open-tools/VentaConnected/Images/PCB/Venta_L45_PCB_00_Parts.jpg

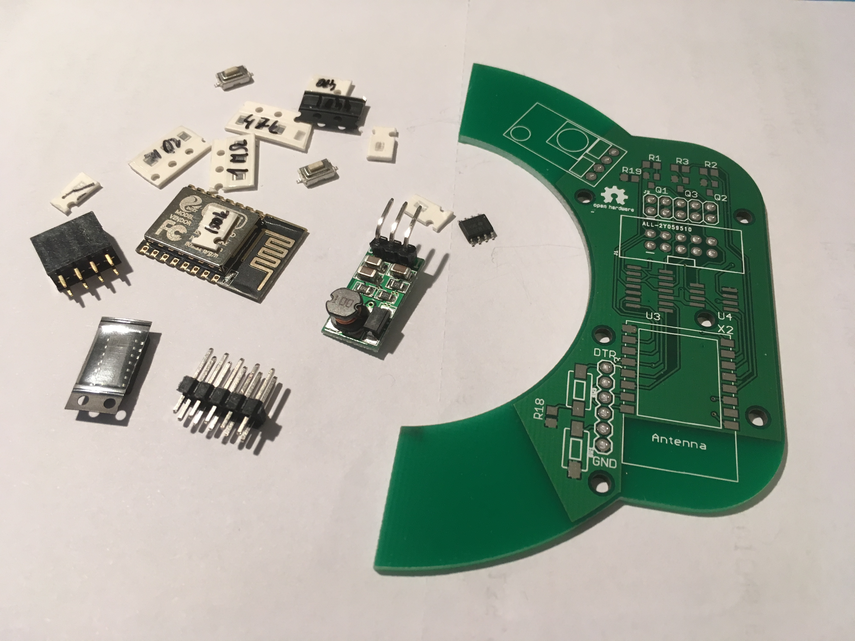
Images/PCB/Venta_L45_PCB_00_Parts.jpg
