open-tools/VentaConnected/Images/Schematics/ESPEasy_Venta_PCB_Schematics.png

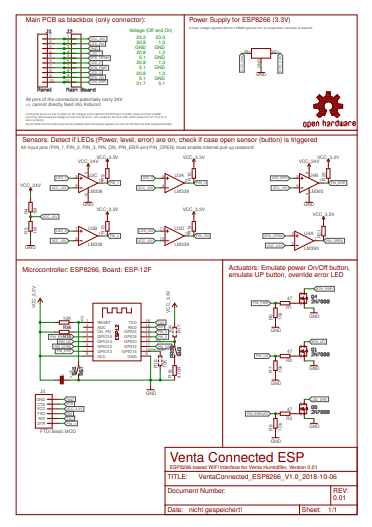
Images/Schematics/ESPEasy_Venta_PCB_Schematics.png
