open-tools/VentaConnected/Maximum_PCB_Outline.pdf

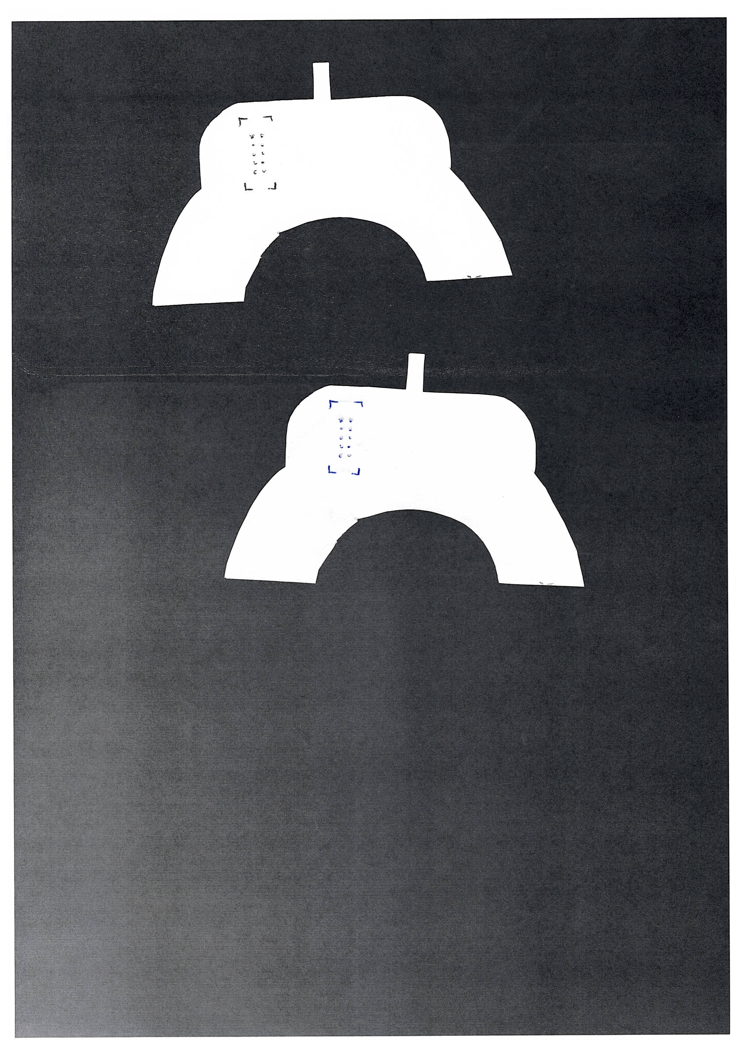
[picture p3: page 1]
