open-tools/VentaConnected/Images/Arduino/20180909_175629.jpg

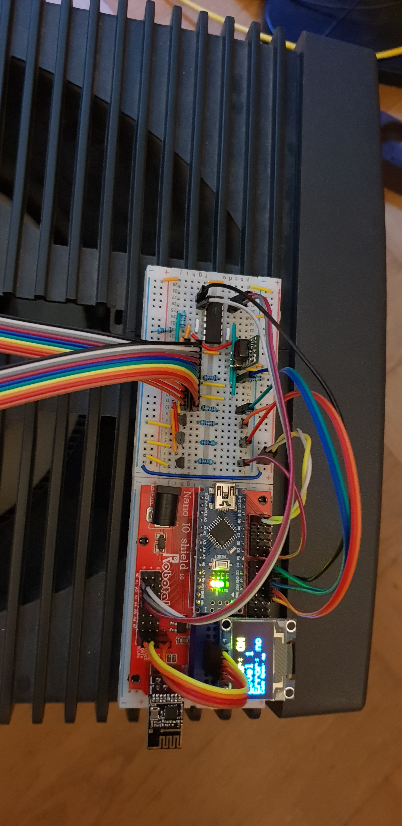
Images/Arduino/20180909_175629.jpg
