open-tools/VentaConnected/Images/Arduino/20180909_180037.jpg

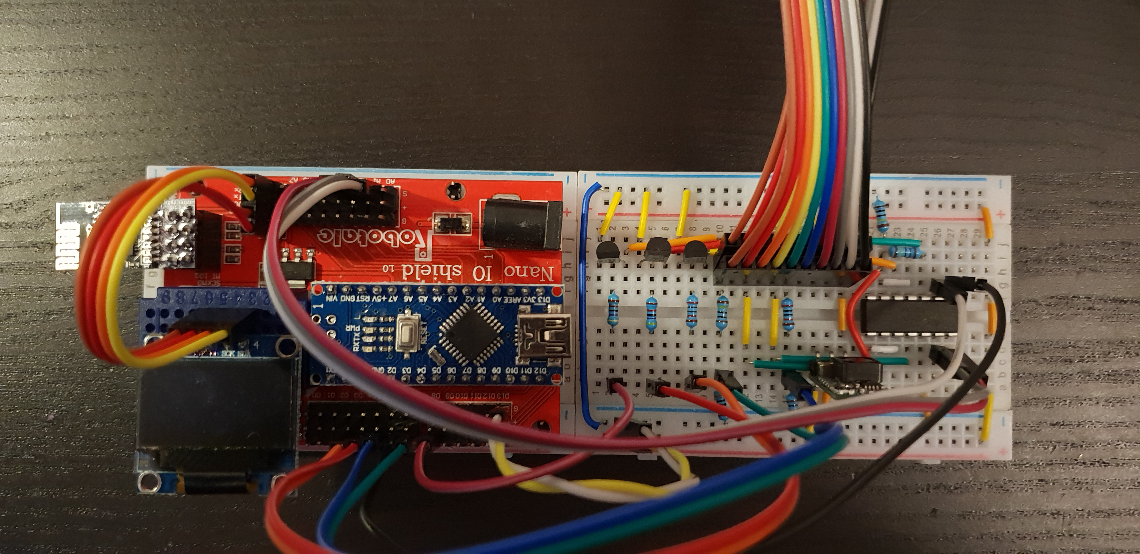
Images/Arduino/20180909_180037.jpg
