open-tools/VentaConnected/Images/Arduino/IMAG2086.jpg

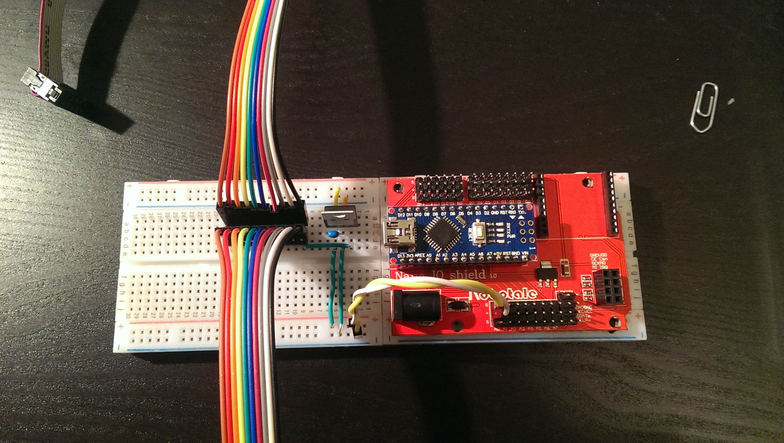
Images/Arduino/IMAG2086.jpg
