open-tools/VentaConnected/Images/Arduino/IMAG2089.jpg

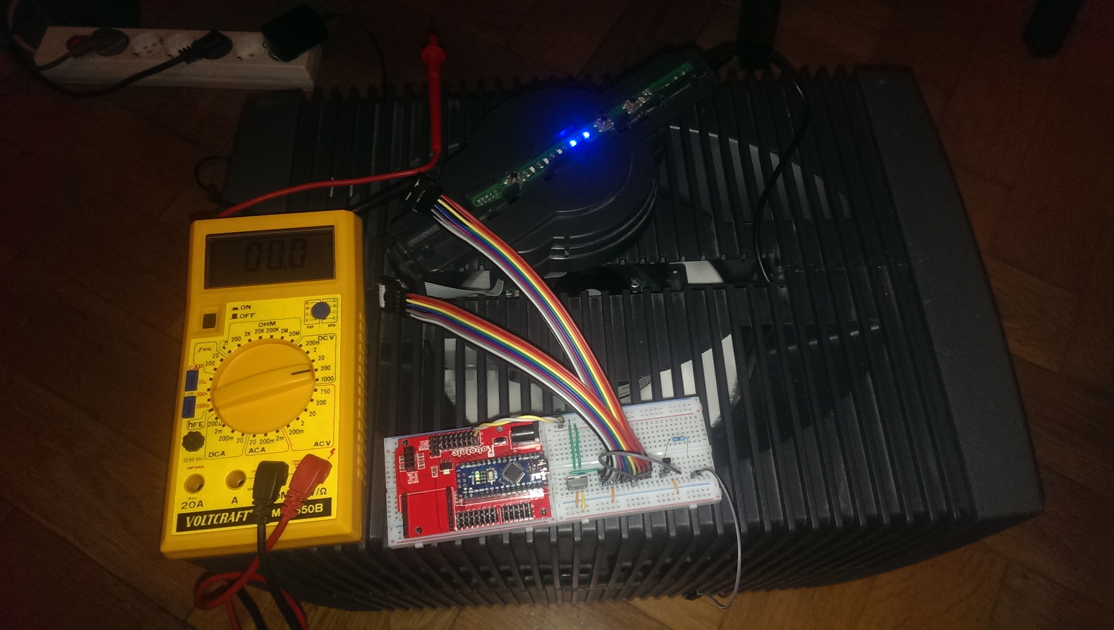
Images/Arduino/IMAG2089.jpg
