open-tools/VentaConnected/Images/Arduino/IMAG2099.jpg

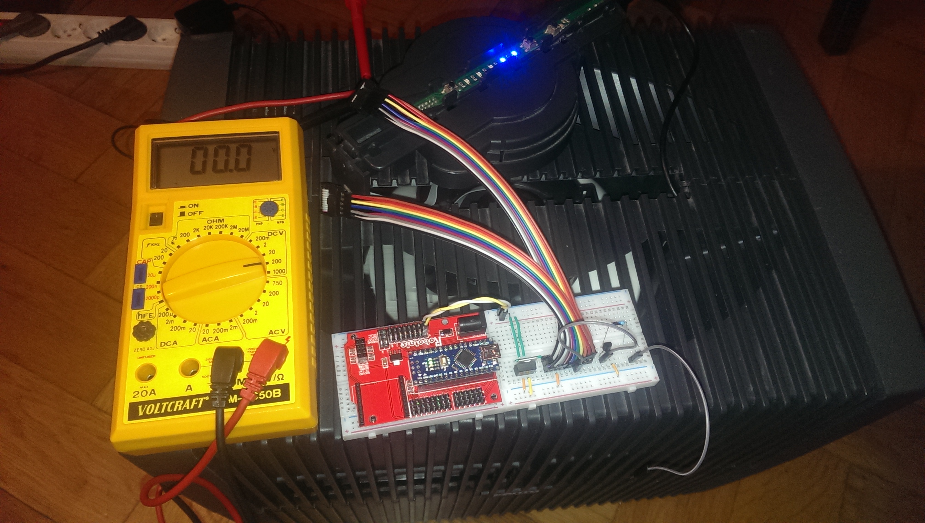
Images/Arduino/IMAG2099.jpg
