open-tools/VentaConnected/Images/Arduino/IMAG2100.jpg

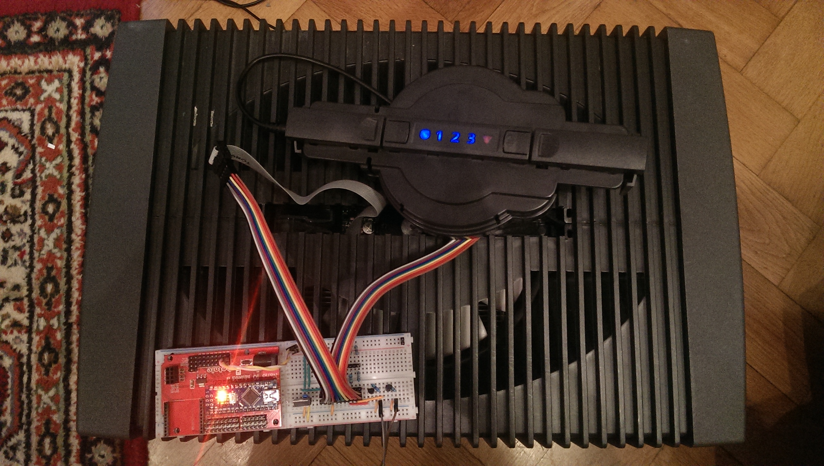
Images/Arduino/IMAG2100.jpg
