open-tools/VentaConnected/Images/Arduino/IMAG2104.jpg

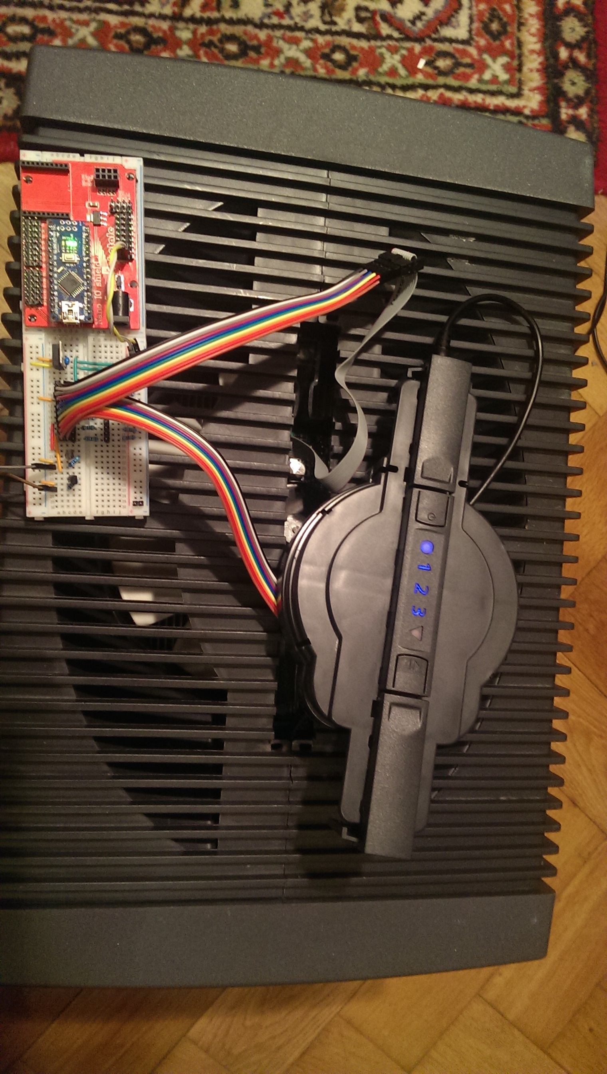
Images/Arduino/IMAG2104.jpg
