open-tools/VentaConnected/Images/Arduino/IMAG2140.jpg

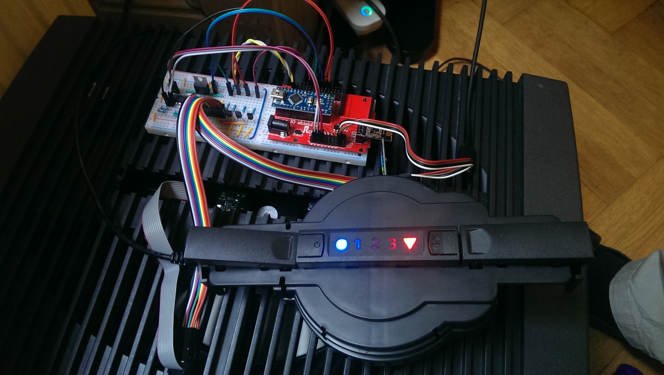
Images/Arduino/IMAG2140.jpg
