open-tools/VentaConnected/Images/Arduino/IMAG2143.jpg

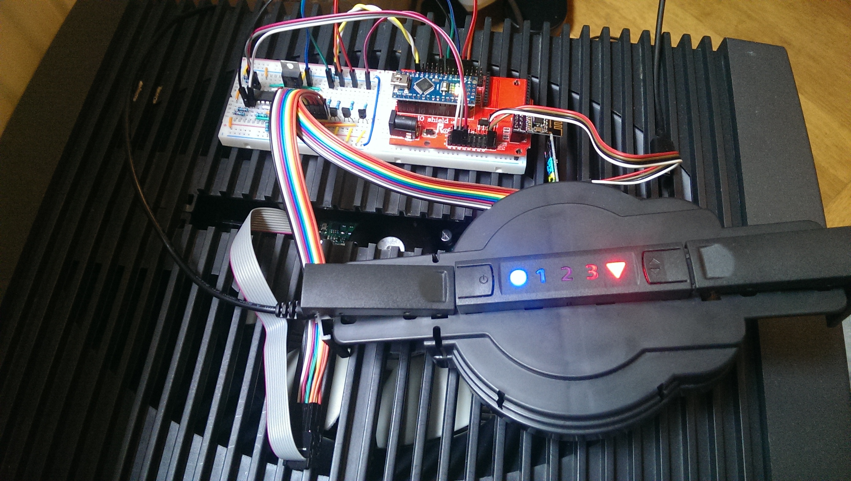
Images/Arduino/IMAG2143.jpg
