open-tools/VentaConnected/Images/Arduino/IMAG2268.jpg

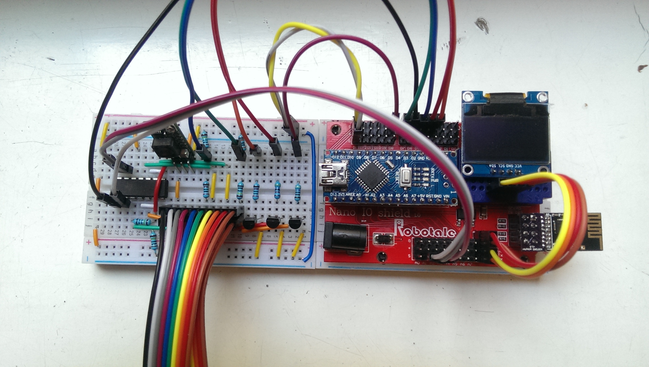
Images/Arduino/IMAG2268.jpg
