open-tools/VentaConnected/Images/Arduino/IMAG2269.jpg

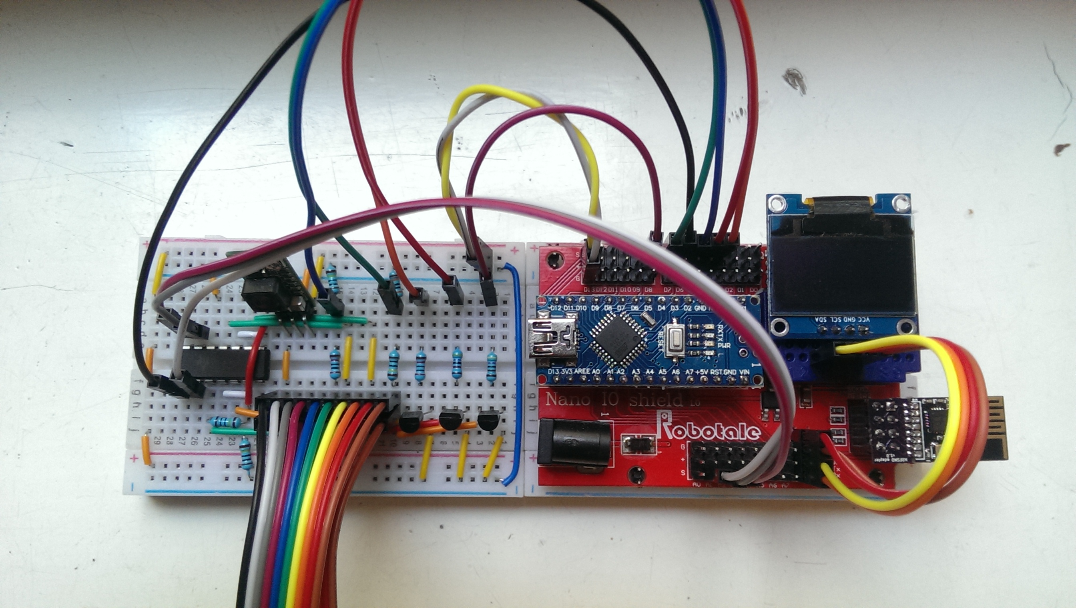
Images/Arduino/IMAG2269.jpg
