open-tools/VentaConnected/Images/Arduino/IMAG2270.jpg

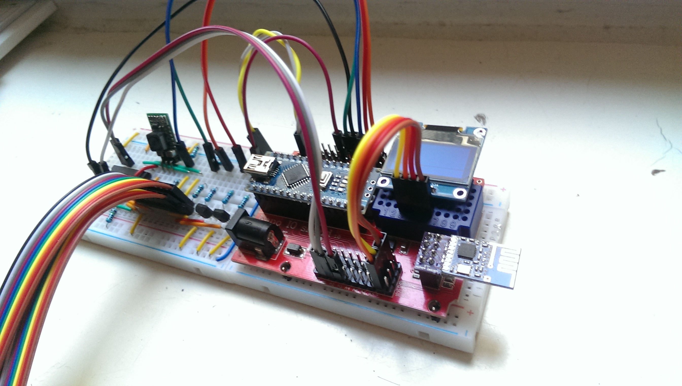
Images/Arduino/IMAG2270.jpg
