open-tools/VentaConnected/Images/Arduino/IMAG2271.jpg

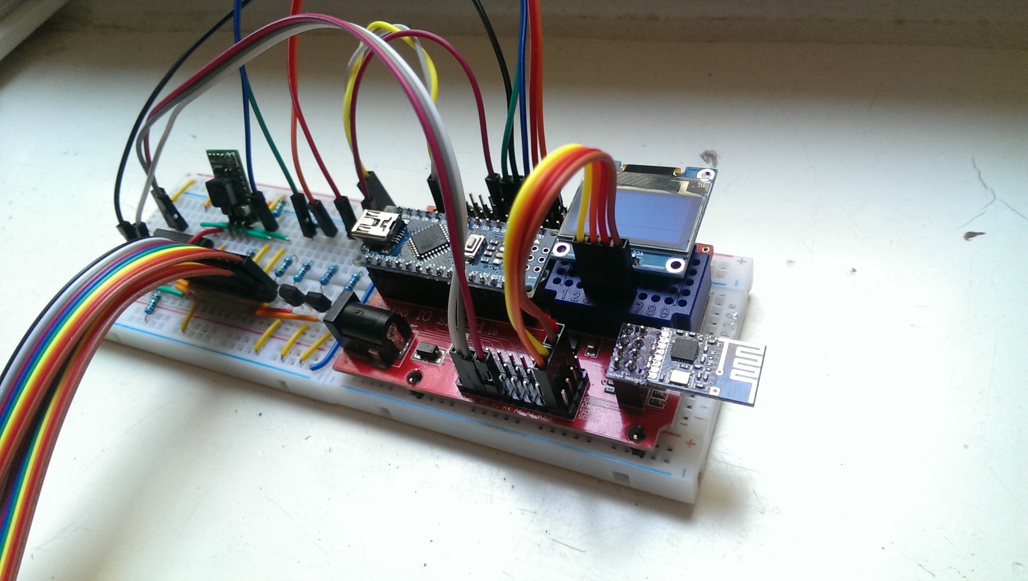
Images/Arduino/IMAG2271.jpg
