open-tools/VentaConnected/Images/Arduino/IMAG2272.jpg

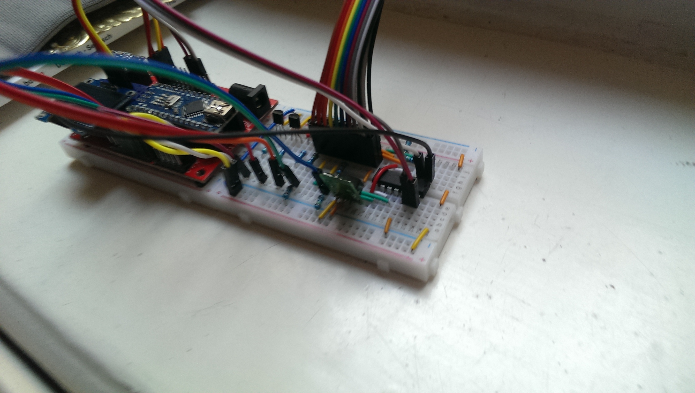
Images/Arduino/IMAG2272.jpg
