open-tools/VentaConnected/Images/Arduino/IMAG2273.jpg

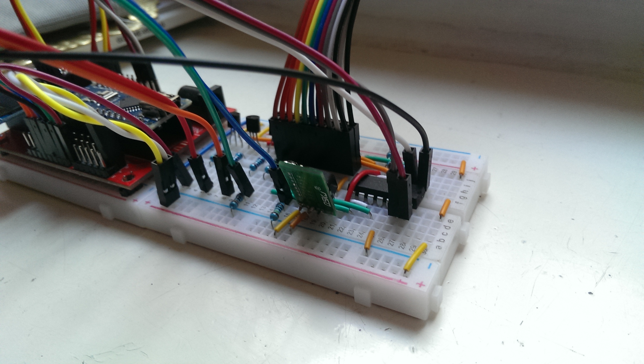
Images/Arduino/IMAG2273.jpg
