open-tools/VentaConnected/Images/Arduino/IMAG2274.jpg

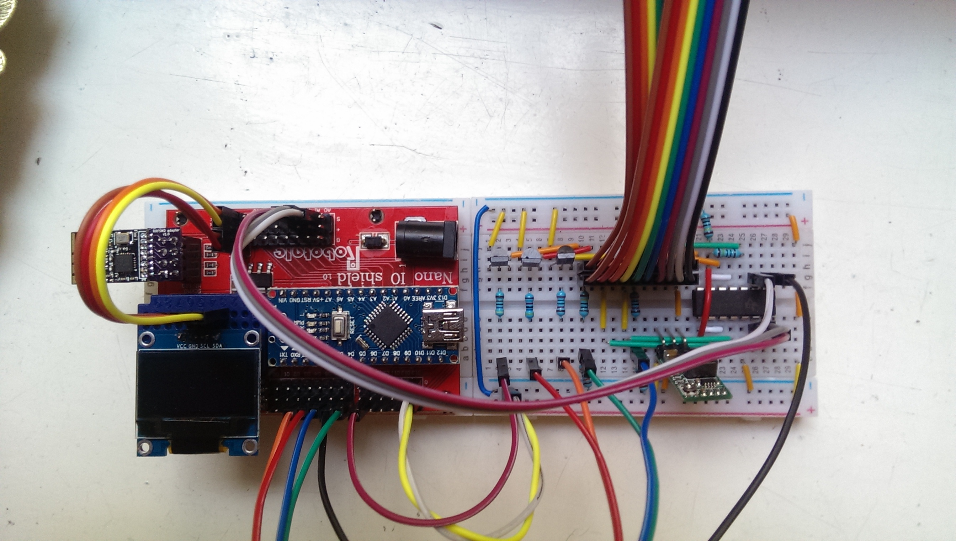
Images/Arduino/IMAG2274.jpg
