open-tools/VentaConnected/Images/Arduino/IMAG2275.jpg

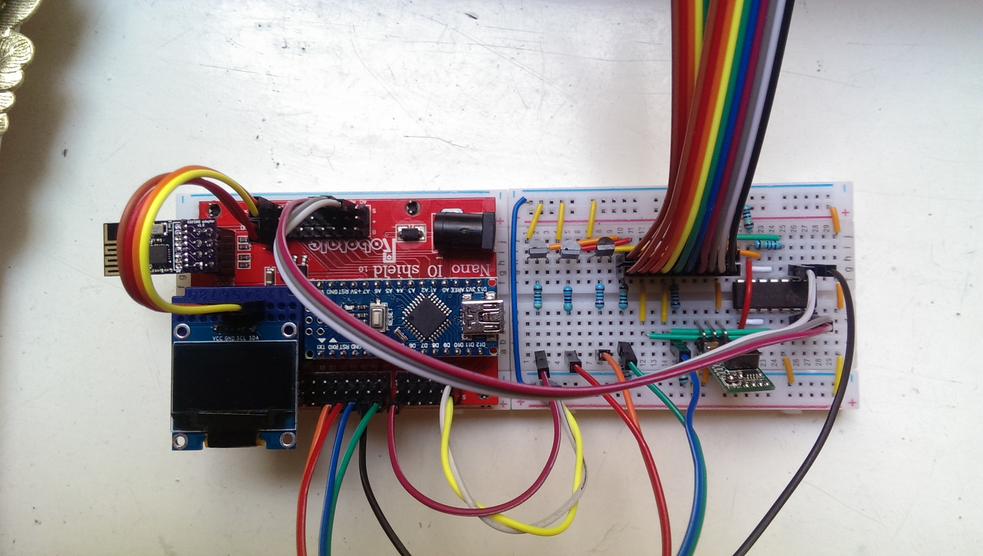
Images/Arduino/IMAG2275.jpg
