open-tools/VentaConnected/Images/Arduino/Venta_LW45_Mysensors_00_breadboard.jpg

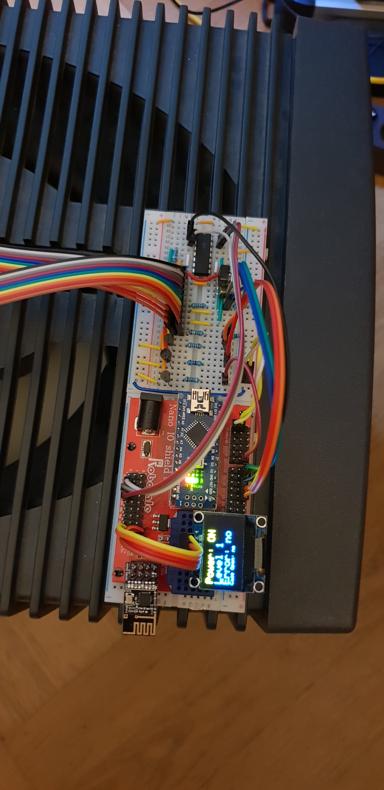
Images/Arduino/Venta_LW45_Mysensors_00_breadboard.jpg
