open-tools/VentaConnected/Images/Arduino/Venta_LW45_MySensors_02_breadboard.jpg

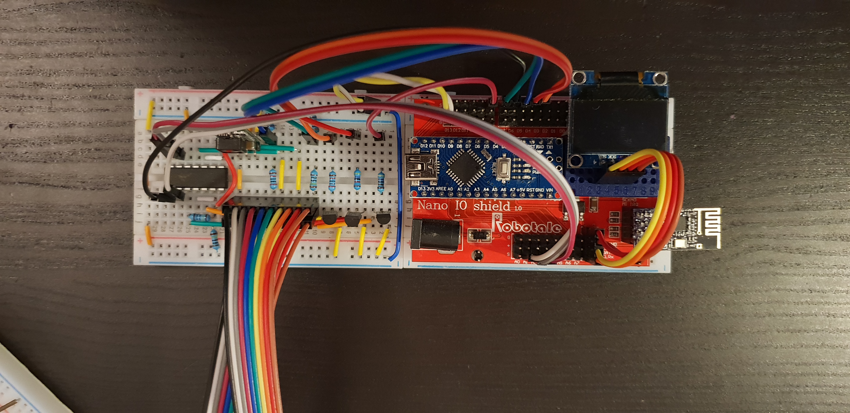
Images/Arduino/Venta_LW45_MySensors_02_breadboard.jpg
