open-tools/VentaConnected/Images/Arduino/Venta_LW45_MySensors_03_Prototype.jpg

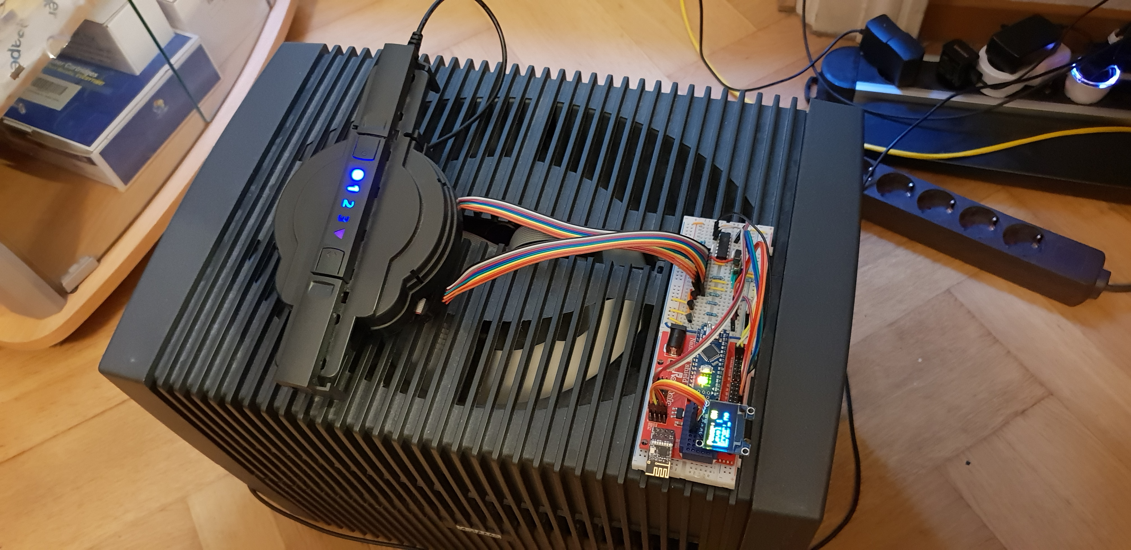
Images/Arduino/Venta_LW45_MySensors_03_Prototype.jpg
