open-tools/VentaConnected/Images/ESP8266/20180907_134929.jpg

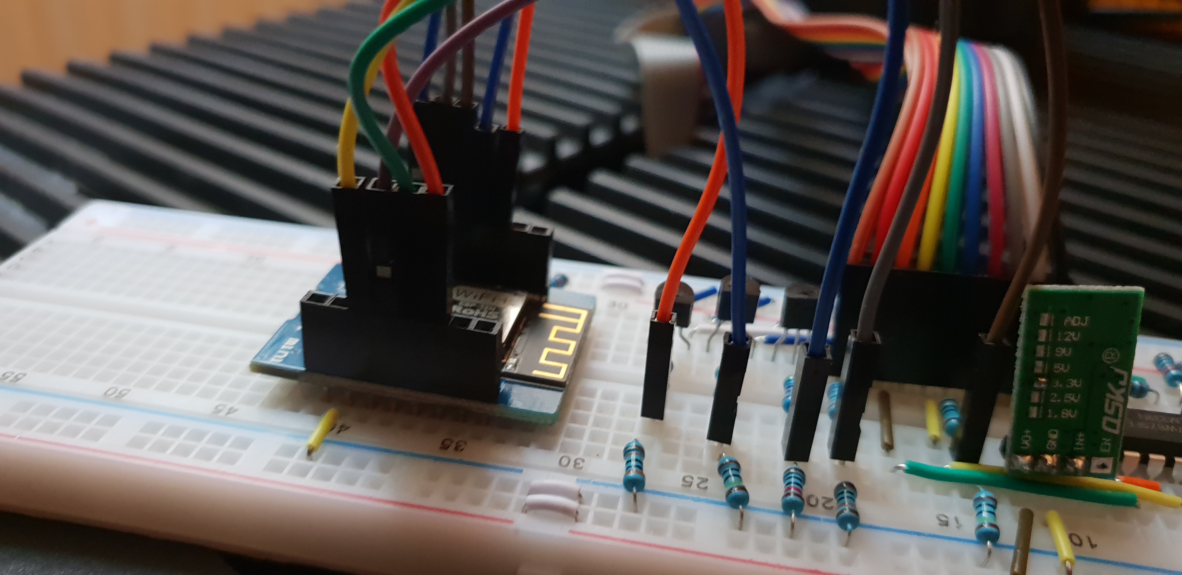
Images/ESP8266/20180907_134929.jpg
