open-tools/VentaConnected/Images/ESP8266/20180907_134935.jpg

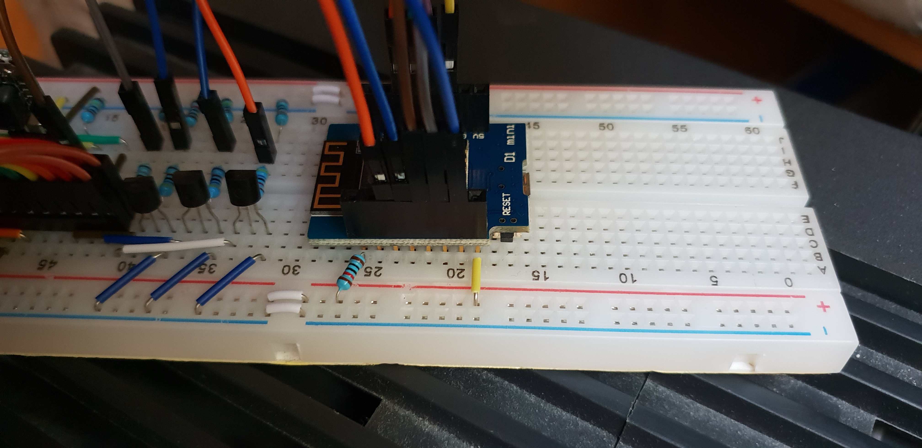
Images/ESP8266/20180907_134935.jpg
