open-tools/VentaConnected/Images/ESP8266/Venta_LW45_ESP_breadboard_06.jpg

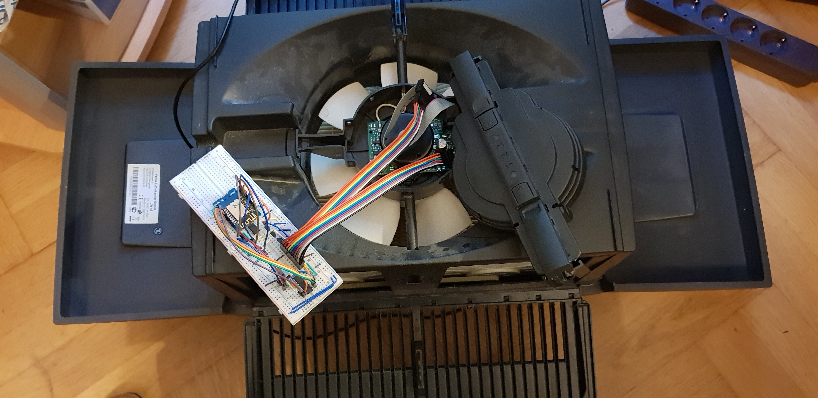
Images/ESP8266/Venta_LW45_ESP_breadboard_06.jpg
