open-tools/VentaConnected/Images/ESPEasy/ESPEasy_Venta_DeviceSettings.png

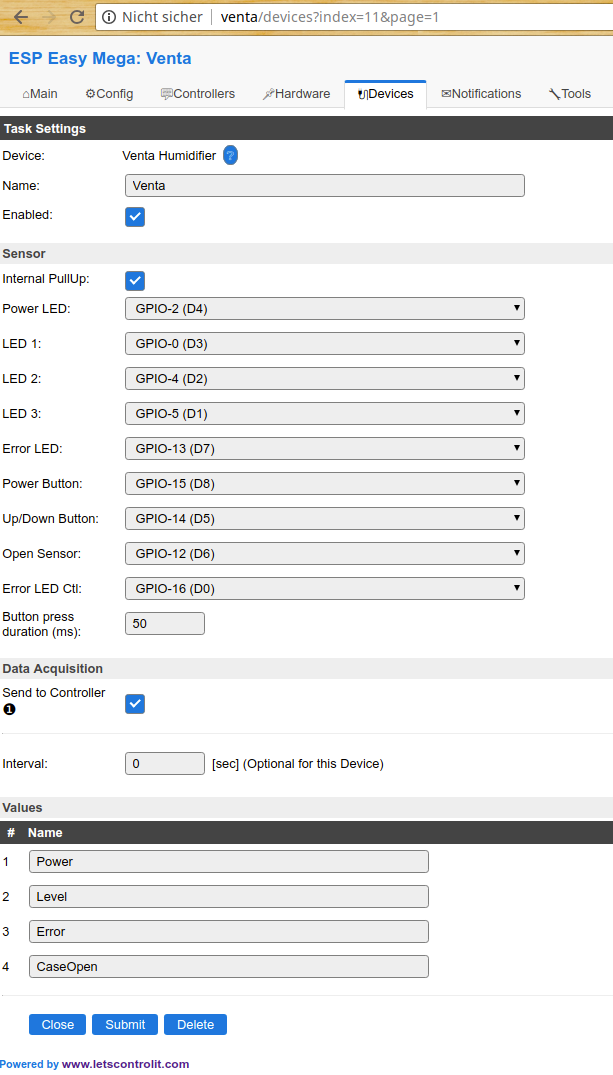
Images/ESPEasy/ESPEasy_Venta_DeviceSettings.png
