open-tools/VentaConnected/Images/ESPEasy/ESPEasy_Venta_Hardware.png

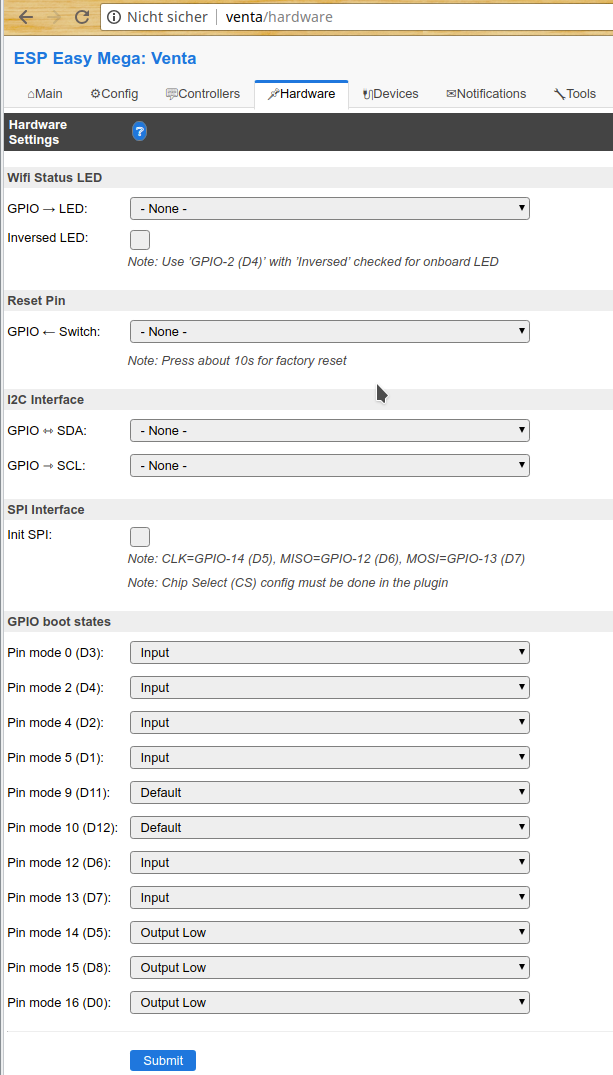
Images/ESPEasy/ESPEasy_Venta_Hardware.png
