open-tools/VentaConnected/Images/MySensors/MySensors_Venta_MyController.png

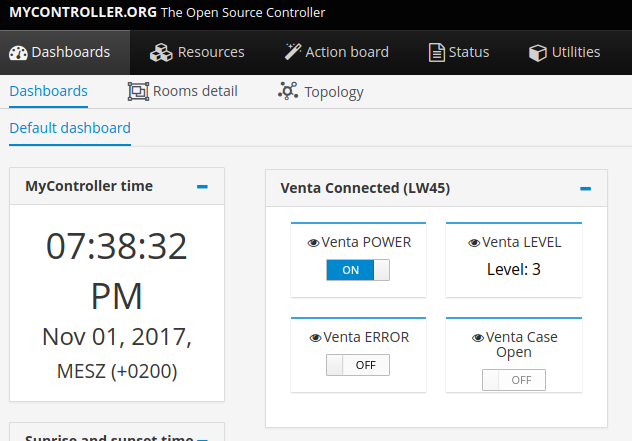
Images/MySensors/MySensors_Venta_MyController.png
