open-tools/VentaConnected/Images/OpenHAB/Venta_LW45_OpenHAB_Floorplan.png

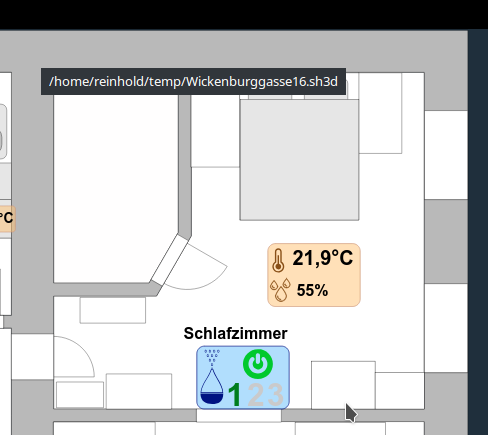
Images/OpenHAB/Venta_LW45_OpenHAB_Floorplan.png
