open-tools/VentaConnected/Images/OpenHAB/Venta_LW45_OpenHAB_Sitemap.png

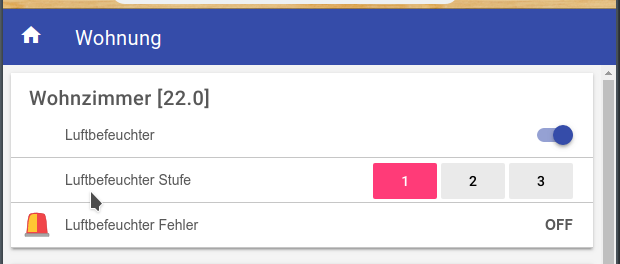
Images/OpenHAB/Venta_LW45_OpenHAB_Sitemap.png
