open-tools/VentaConnected/Images/PCB/FTDI_PogoPins.jpg

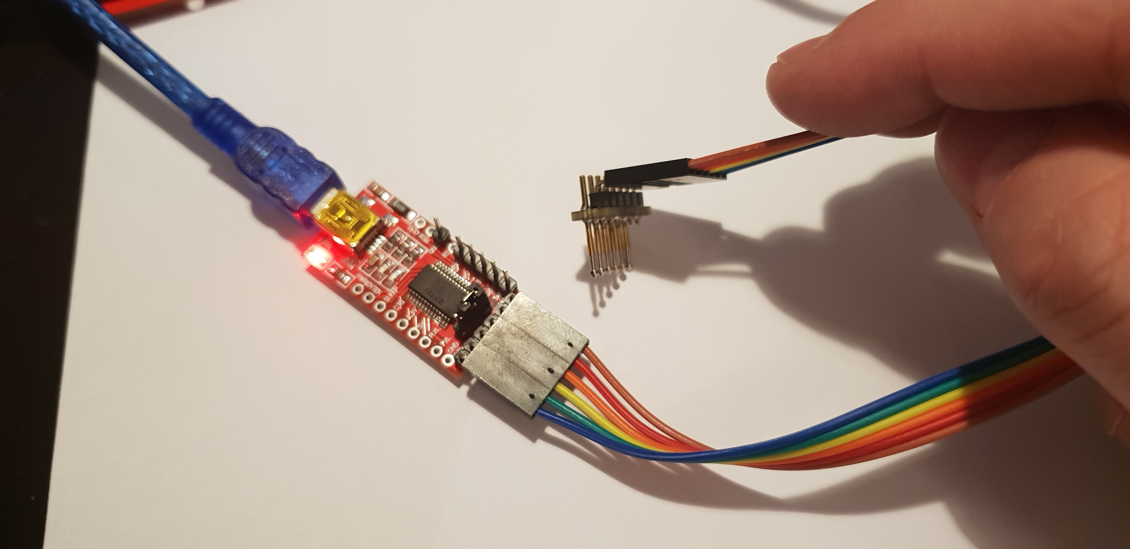
Images/PCB/FTDI_PogoPins.jpg
