open-tools/VentaConnected/Images/PCB/FTDI_PogoPins_PressAgainstPCB.jpg

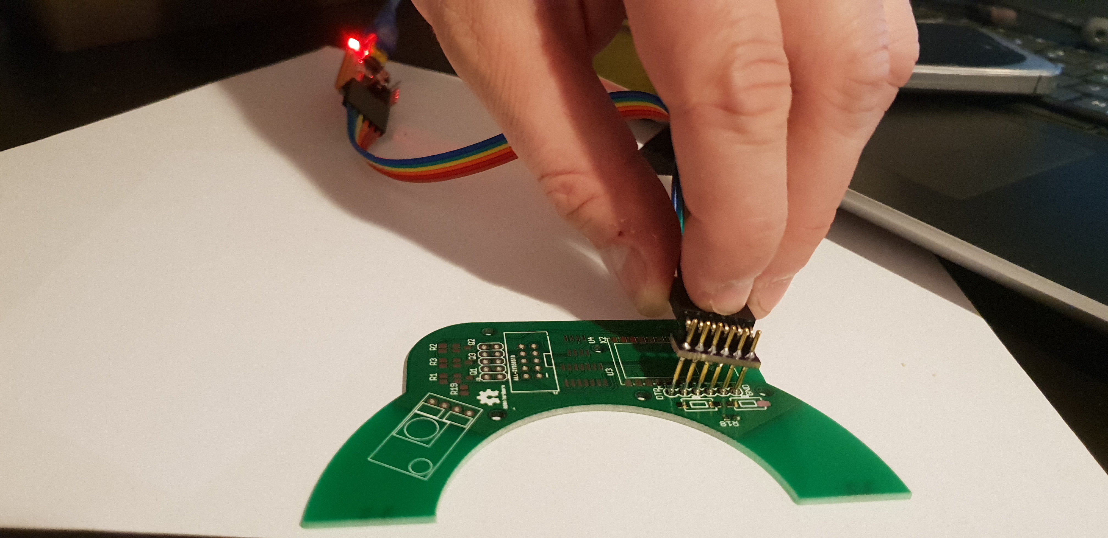
Images/PCB/FTDI_PogoPins_PressAgainstPCB.jpg
