open-tools/VentaConnected/Images/PCB/Venta_L45_PCB_01_Top.jpg

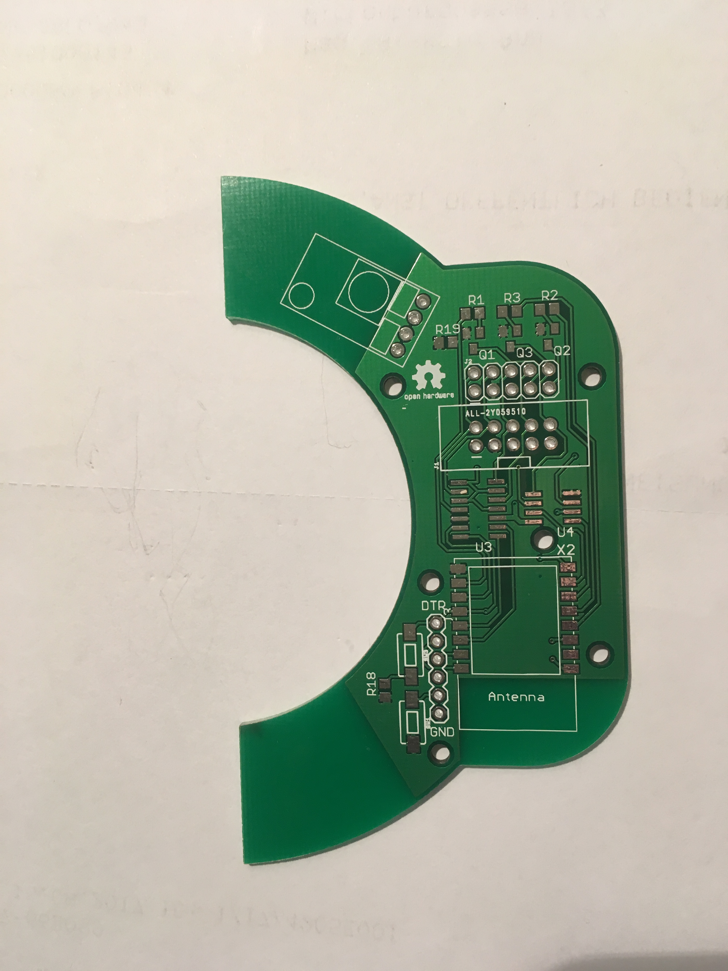
Images/PCB/Venta_L45_PCB_01_Top.jpg
