open-tools/VentaConnected/Images/PCB/Venta_L45_PCB_02_Bottom.jpg

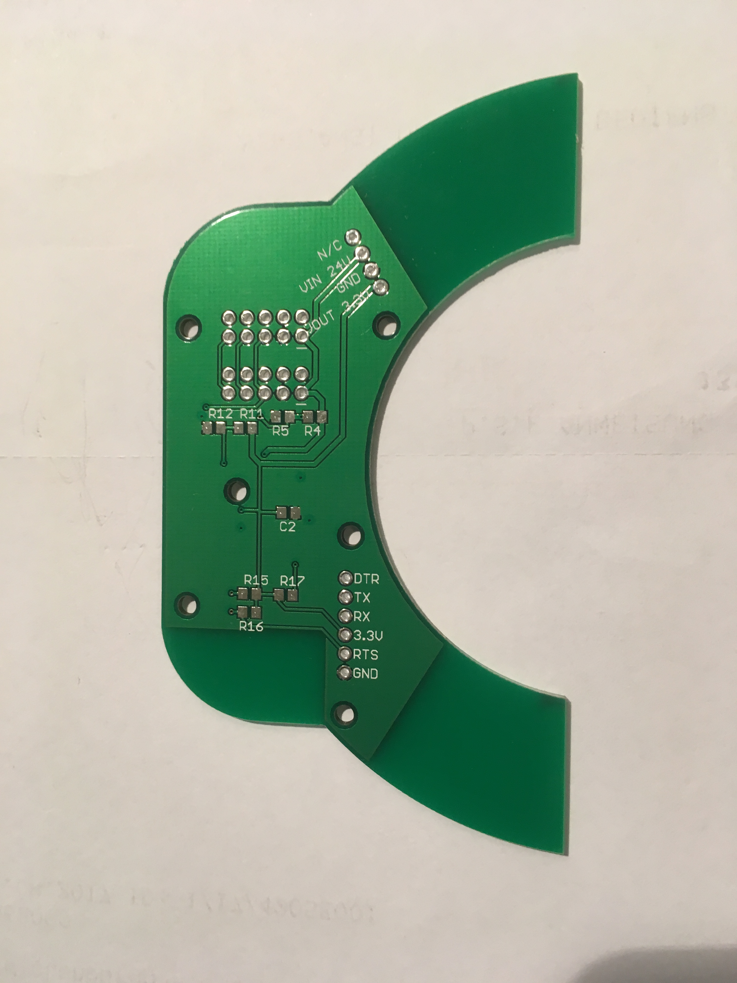
Images/PCB/Venta_L45_PCB_02_Bottom.jpg
