open-tools/VentaConnected/Images/PCB/Venta_L45_PCB_03_Built.jpg

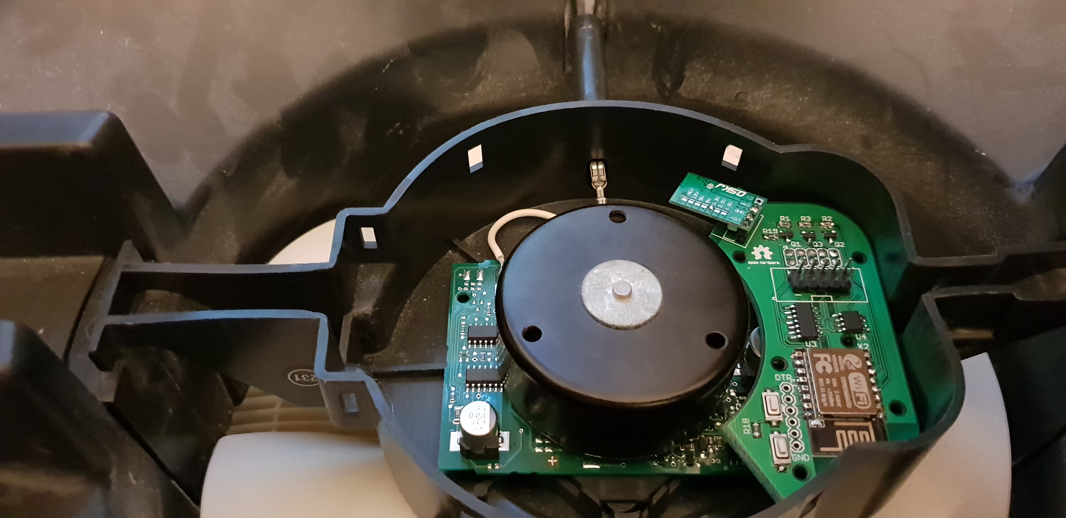
Images/PCB/Venta_L45_PCB_03_Built.jpg
