open-tools/VentaConnected/Images/Schematics/ESPEasy_Venta_DetectLEDStatus.png

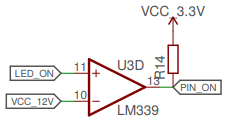
Images/Schematics/ESPEasy_Venta_DetectLEDStatus.png
