open-tools/VentaConnected/Images/Schematics/ESPEasy_Venta_EmulateButton.png

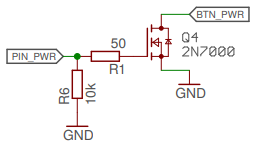
Images/Schematics/ESPEasy_Venta_EmulateButton.png
