open-tools/VentaConnected/Images/Schematics/ESPEasy_Venta_Microcontroller_ESP8266.png

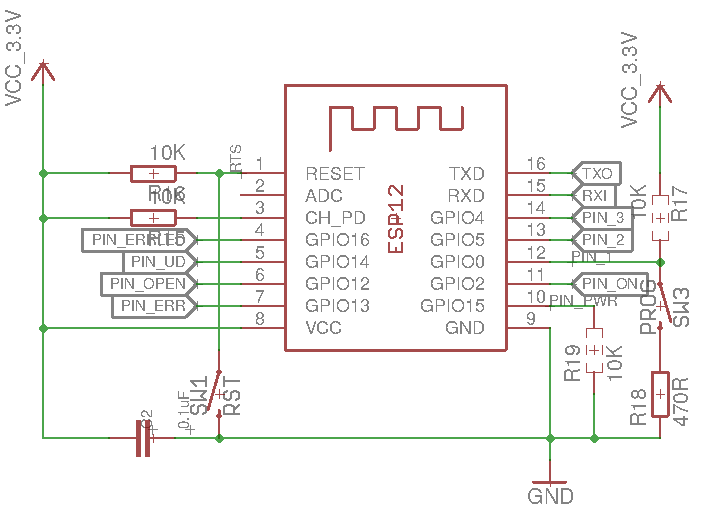
Images/Schematics/ESPEasy_Venta_Microcontroller_ESP8266.png
