open-tools/VentaConnected/Images/Schematics/ESPEasy_Venta_PCB_Bottom.png

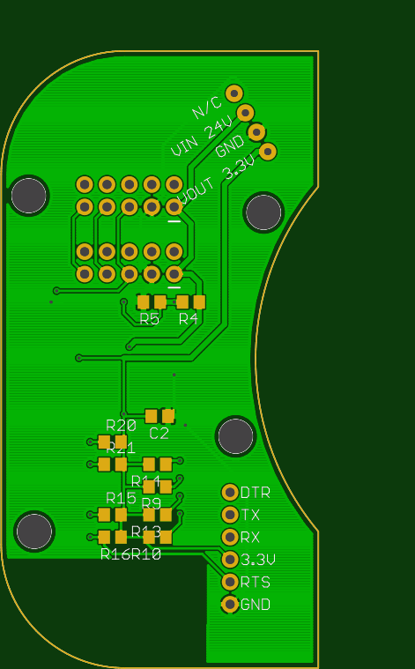
Images/Schematics/ESPEasy_Venta_PCB_Bottom.png
