open-tools/VentaConnected/Images/Schematics/ESPEasy_Venta_PCB_Top.png

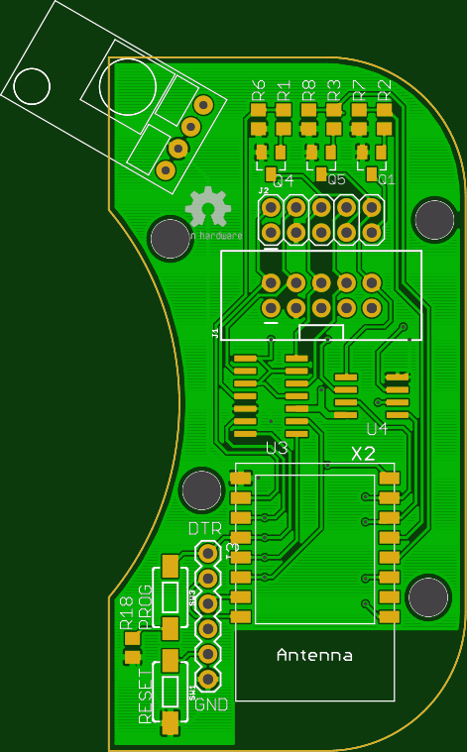
Images/Schematics/ESPEasy_Venta_PCB_Top.png
