open-tools/VentaConnected/Images/Schematics/VentaLW45_ControlPanel_Schematics.png

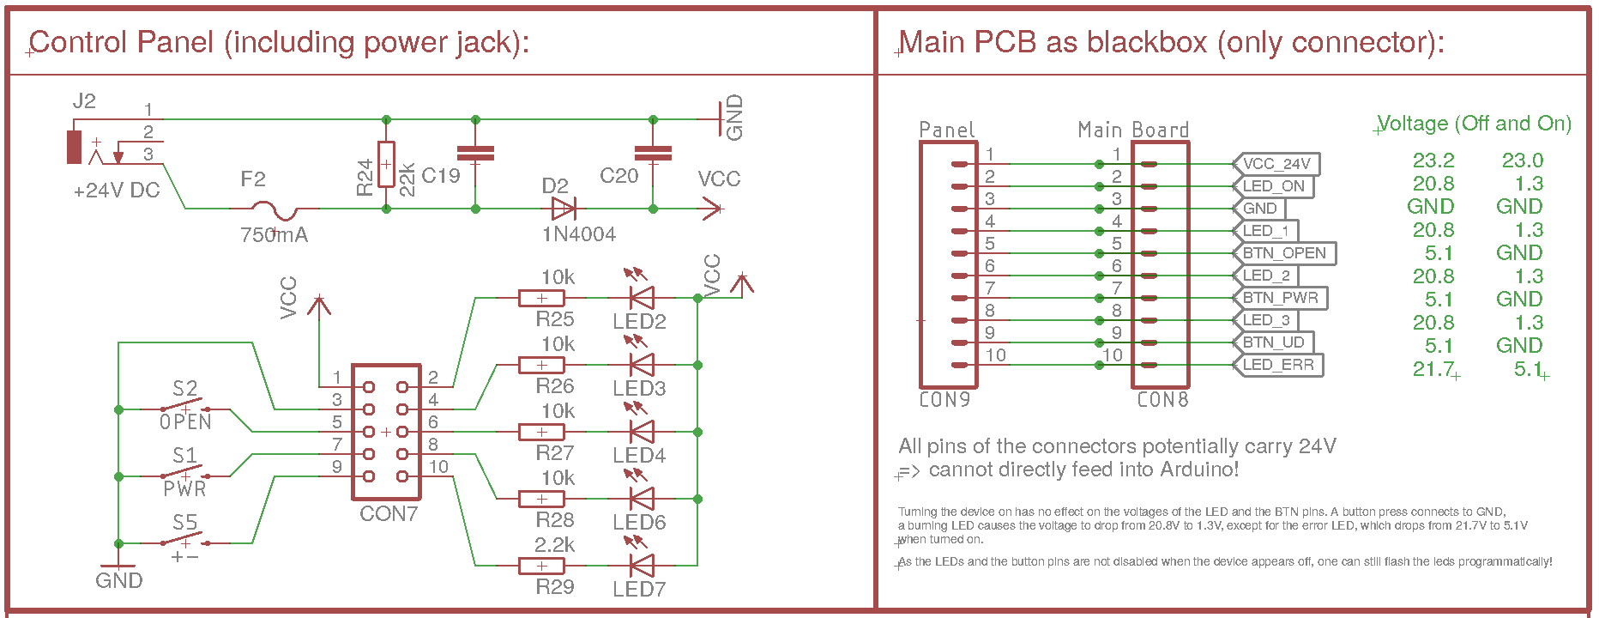
Images/Schematics/VentaLW45_ControlPanel_Schematics.png
