open-tools/VentaConnected/Images/Venta/20180909_175750.jpg

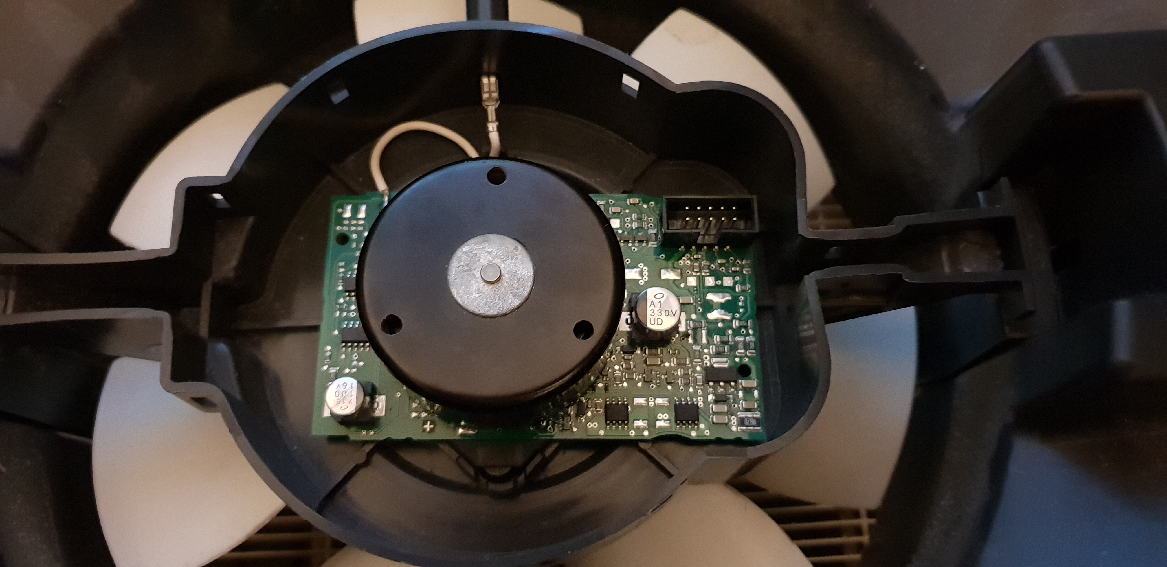
Images/Venta/20180909_175750.jpg
