open-tools/VentaConnected/Images/Venta/IMAG2036.jpg

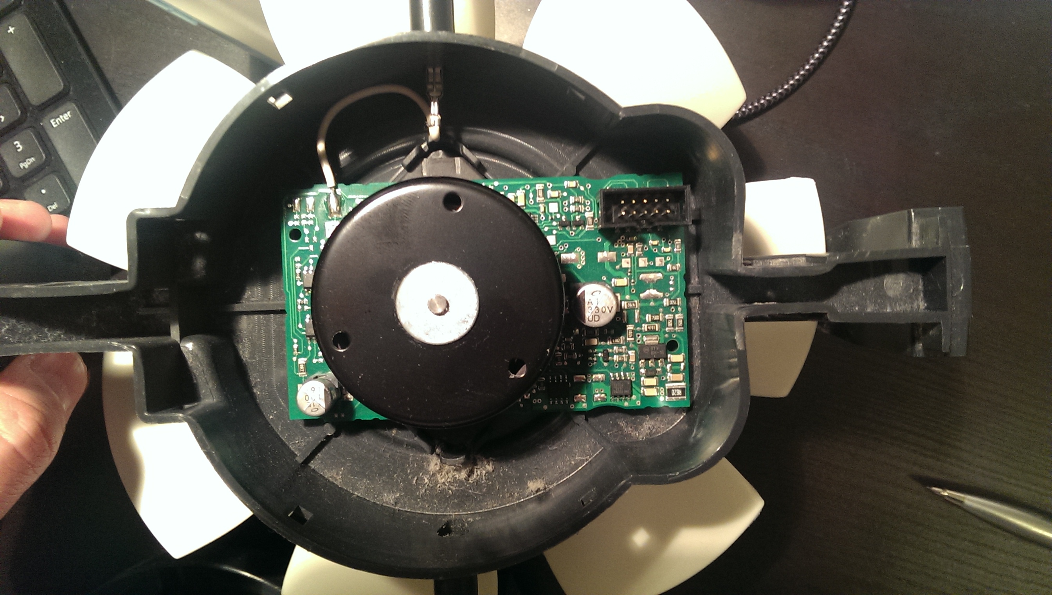
Images/Venta/IMAG2036.jpg
