open-tools/VentaConnected/Images/Venta/IMAG2050.jpg

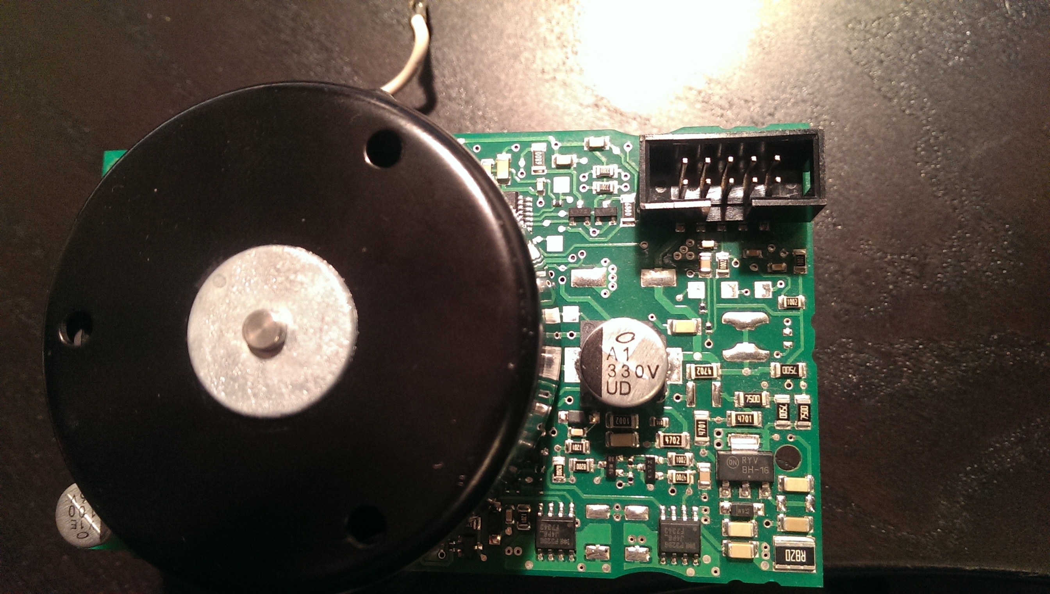
Images/Venta/IMAG2050.jpg
