open-tools/VentaConnected/Images/Venta/Venta_LW45_00_Opened.jpg

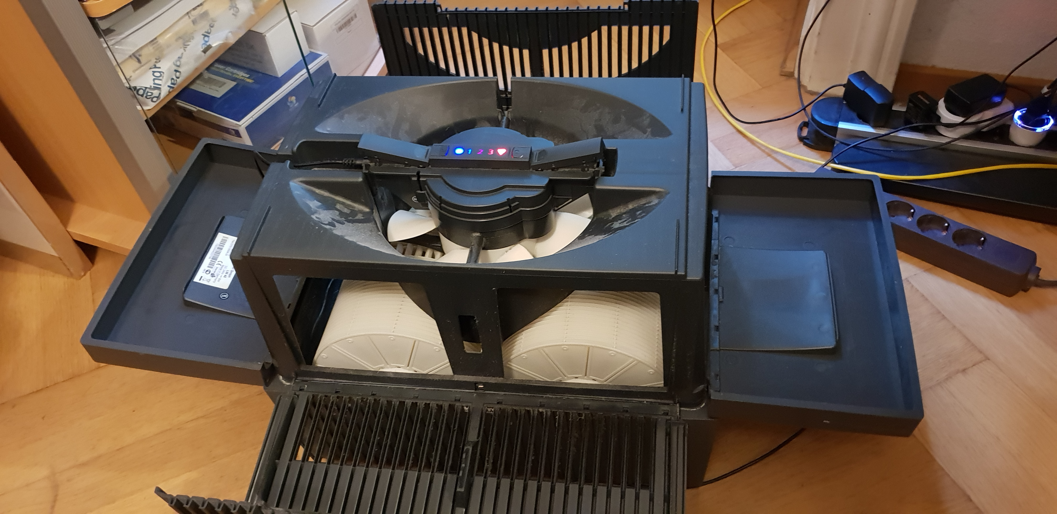
Images/Venta/Venta_LW45_00_Opened.jpg
