open-tools/VentaConnected/Images/Venta/Venta_LW45_01_Opened.JPG

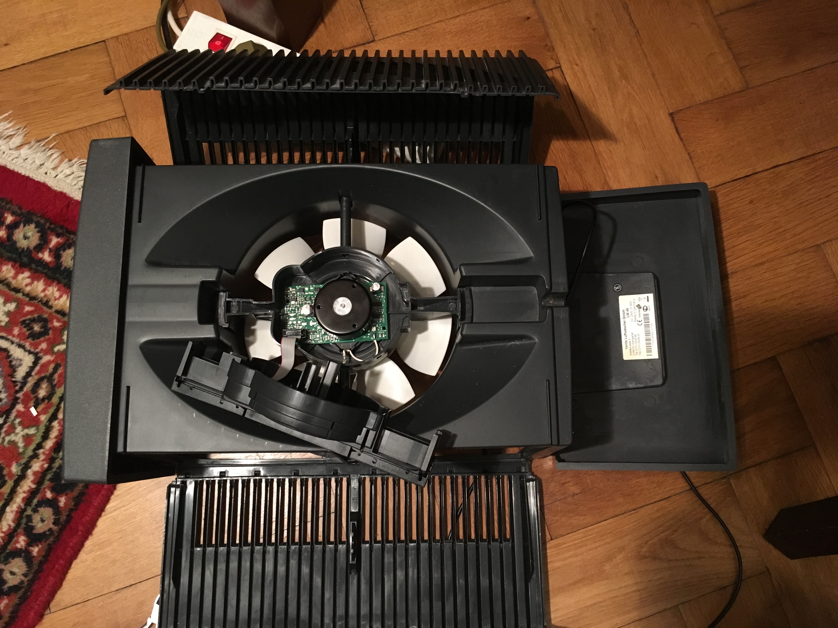
Images/Venta/Venta_LW45_01_Opened.JPG
