open-tools/VentaConnected/Images/Venta/Venta_LW45_02_MainPCB.JPG

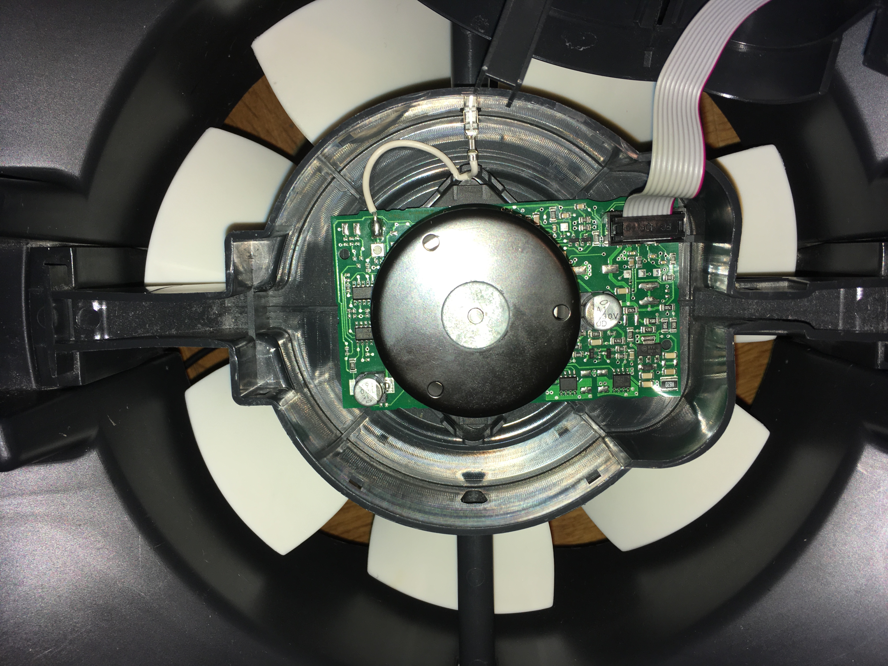
Images/Venta/Venta_LW45_02_MainPCB.JPG
