open-tools/VentaConnected/Images/Venta/Venta_LW45_03_ControlPanel.jpg

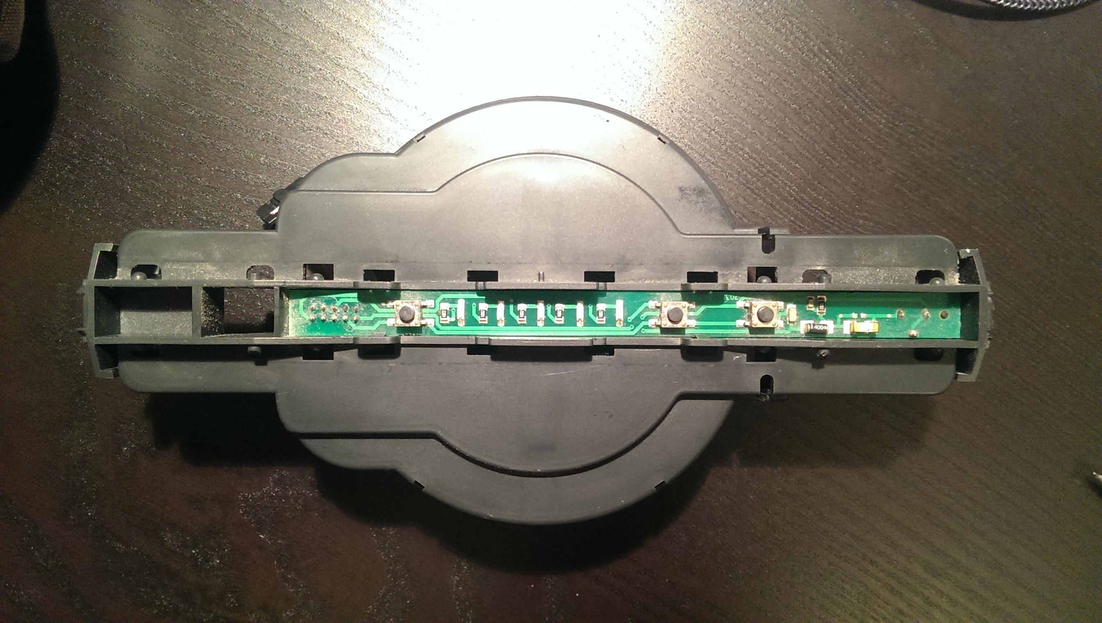
Images/Venta/Venta_LW45_03_ControlPanel.jpg
