open-tools/VentaConnected/Images/MySensors/MySensors_Venta_SerialDebugOutput.png

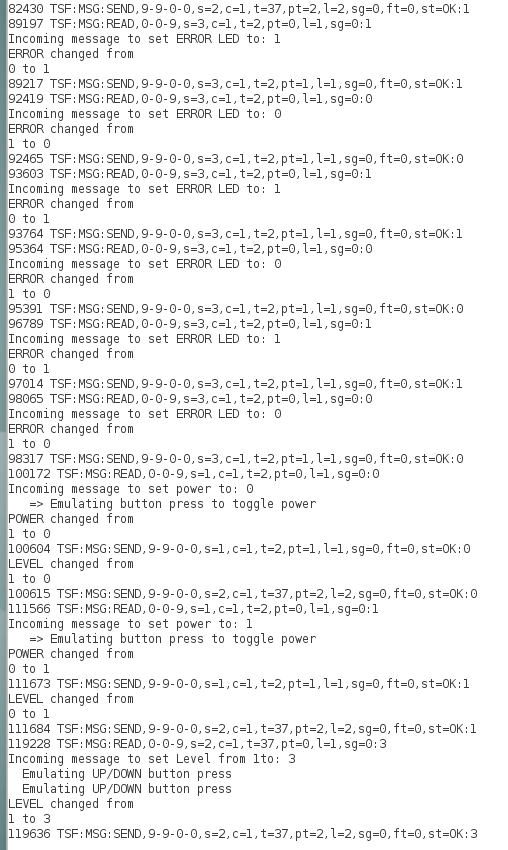
Images/MySensors/MySensors_Venta_SerialDebugOutput.png
