open-tools/VentaConnected/VentaConnected_ESP8266_V1.0_2018-10-06.brd

## EAGLE design VentaConnected_ESP8266_V1.0_2018-10-06.brd (2018-10-14)

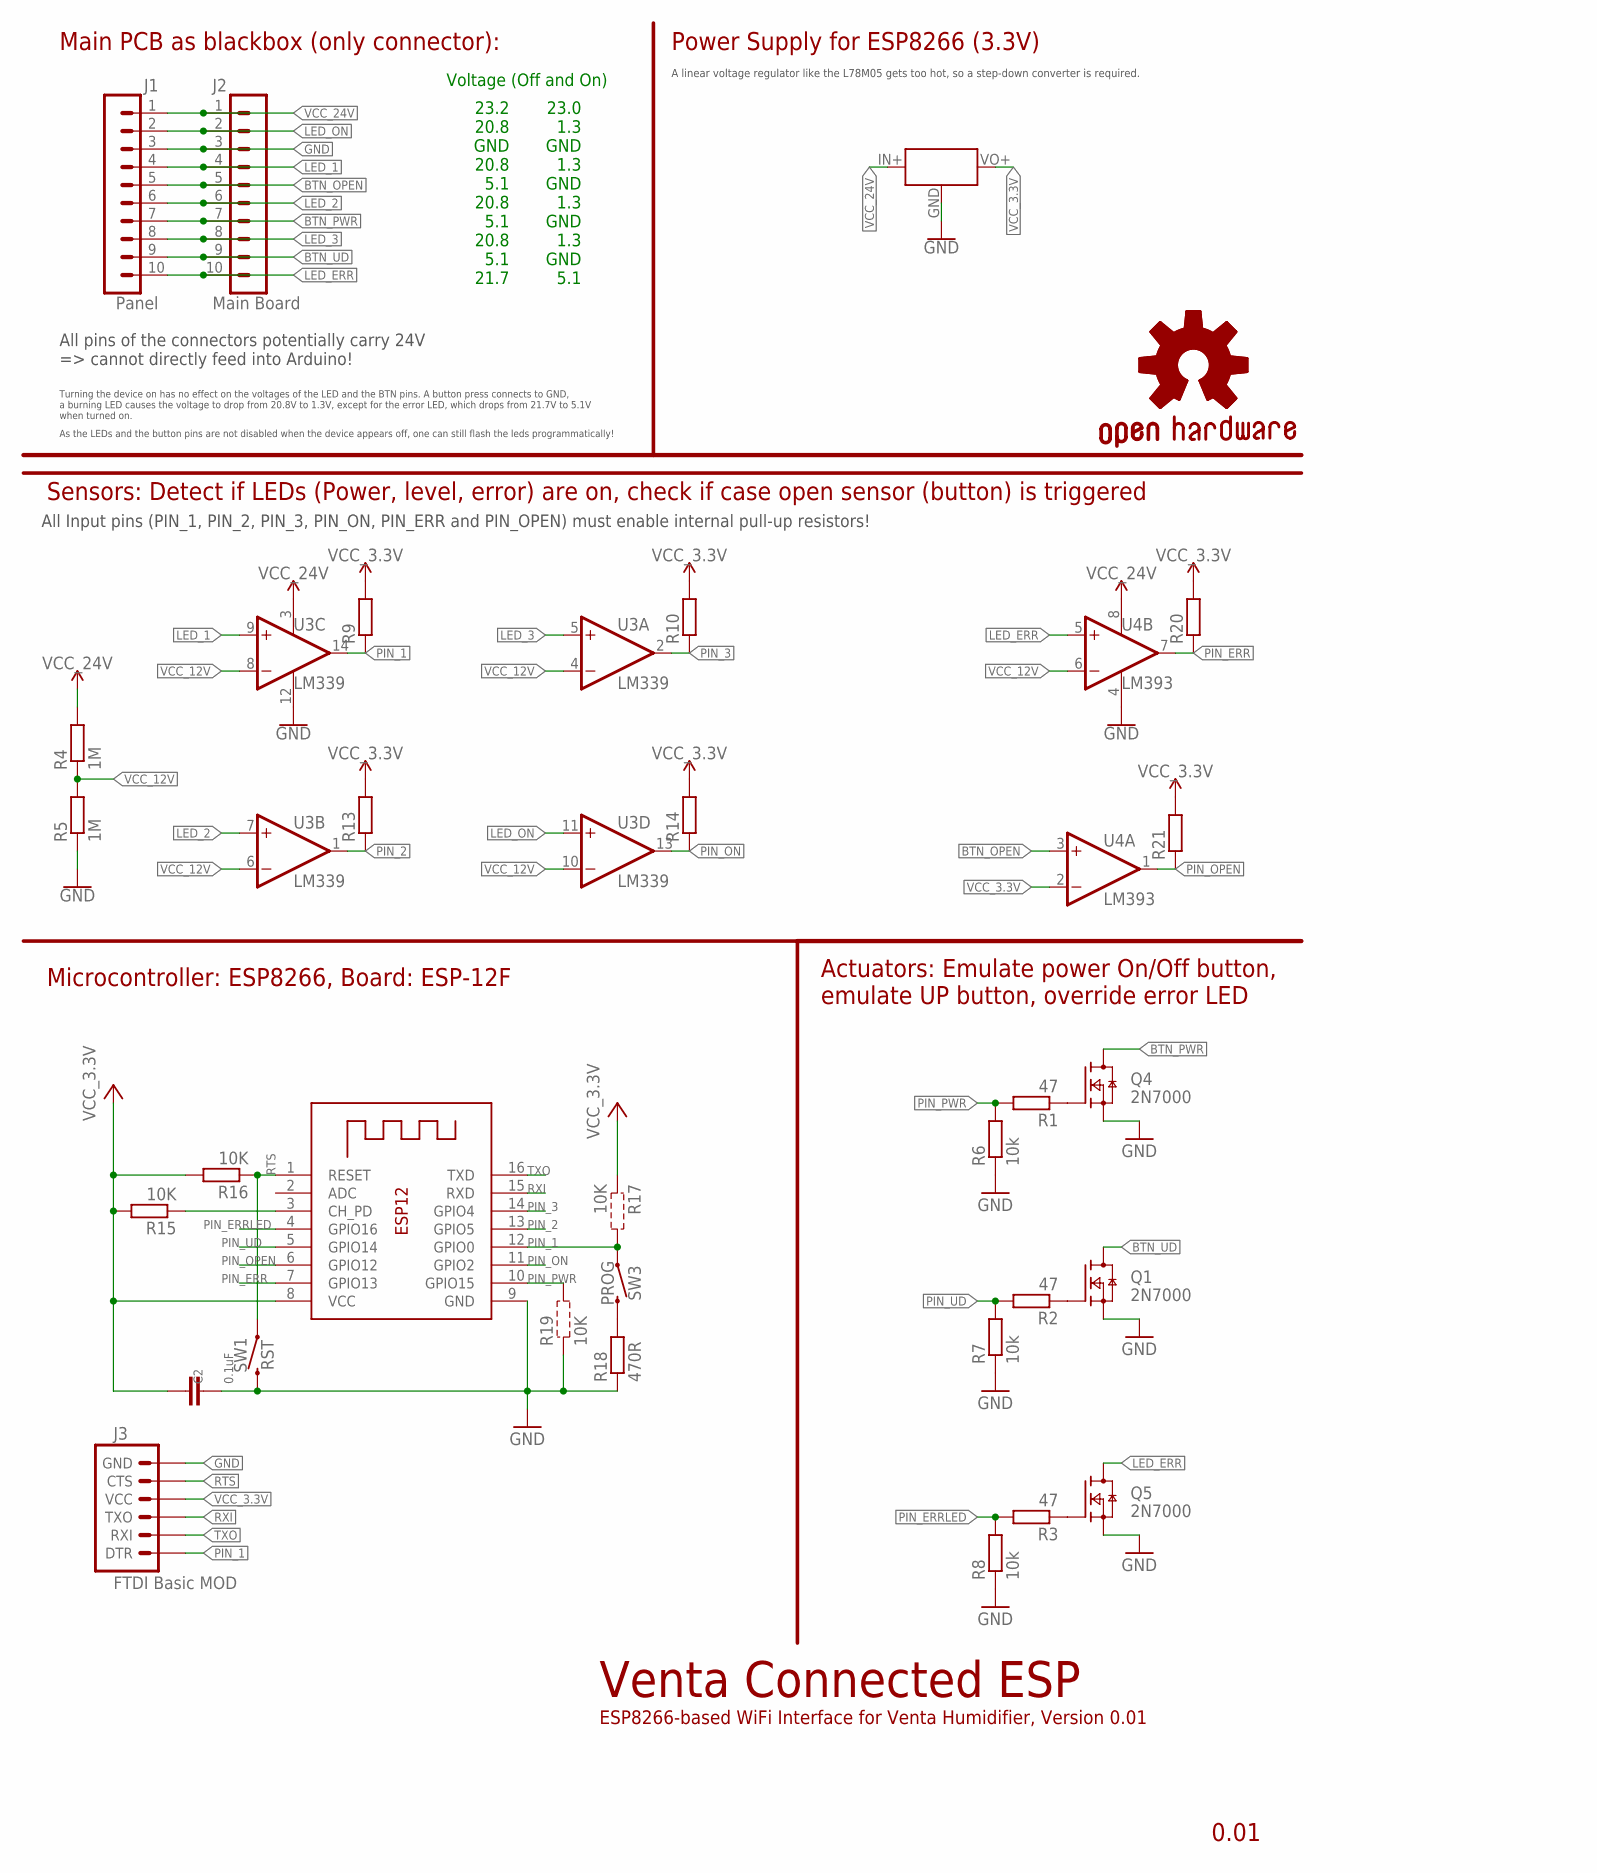
[picture p59: schematic VentaConnected_ESP8266_V1.0_2018-10-06.sch]

Parts:
C2: 0.1uF; C0805
GOLD_ORB_SM1: OSHWLOGO_GOLD_ORB_SM; OSHW2
J1: Panel; 2X5-SHROUDED
J2: Main Board; 2X5
J3: FTDI Basic MOD; 1X06
Q1, Q4, Q5: 2N7000; SOT23
R1, R2, R3: 47; R0805
R4, R5: 1M; R0805
R6, R7, R8: 10k; R0805
R9, R10, R13, R14, R20, R21: R-EU_R0805; R0805
R15, R16: 10K; R0805
R18: 470R; R0805
SW1: RST; TACTILE_SWITCH_SMD_6.0X3.5MM
SW3: PROG; TACTILE_SWITCH_SMD_6.0X3.5MM
U2: 3.3V_BUCK_CONVERTER; MINI_BUCK_CONVERTER_UPDOWN
U3: LM339; SO14
U4: LM393; SO08
X2: ESP-12e; ESP-12

Connections:
BTN_OPEN: J1.5, J2.5, U4.3 (+IN)
BTN_PWR: J1.7, J2.7, Q4.3 (D)
BTN_UD: J1.9, J2.9, Q1.3 (D)
CH_PD: R15.1, X2.3 (CH_PD)
GND: C2.1, J1.3, J2.3, J3.6 (GND), Q1.2 (S), Q4.2 (S), Q5.2 (S), R5.1, R6.1, R7.1, R8.1, R18.1, SW1.2, U2.GND, U3.12 (V-), U4.4 (V-), X2.9 (GND)
LED_1: J1.4, J2.4, U3.9 (+IN)
LED_2: J1.6, J2.6, U3.7 (+IN)
LED_3: J1.8, J2.8, U3.5 (+IN)
LED_ERR: J1.10, J2.10, Q5.3 (D), U4.5 (+IN)
LED_ON: J1.2, J2.2, U3.11 (+IN)
unnamed: Q4.1 (G), R1.1
unnamed: R18.2, SW3.2
unnamed: Q5.1 (G), R3.1
unnamed: Q1.1 (G), R2.1
PIN_1: J3.1 (DTR), R9.1, SW3.1, U3.14 (OUT), X2.12 (GPIO0)
PIN_2: R13.1, U3.1 (OUT), X2.13 (GPIO5)
PIN_3: R10.1, U3.2 (OUT), X2.14 (GPIO4)
PIN_ERR: R20.1, U4.7 (OUT), X2.7 (GPIO13)
PIN_ERRLED: R3.2, R8.2, X2.4 (GPIO16)
PIN_ON: R14.1, U3.13 (OUT), X2.11 (GPIO2)
PIN_OPEN: R21.1, U4.1 (OUT), X2.6 (GPIO12)
PIN_PWR: R1.2, R6.2, X2.10 (GPIO15)
PIN_UD: R2.2, R7.2, X2.5 (GPIO14)
RTS: J3.5 (CTS), R16.1, SW1.1, X2.1 (RESET)
RXI: J3.3 (TXO), X2.15 (RXD)
TXO: J3.2 (RXI), X2.16 (TXD)
VCC_3.3V: C2.2, J3.4 (VCC), R9.2, R10.2, R13.2, R14.2, R15.2, R16.2, R20.2, R21.2, U2.VO+ (VOUT), U4.2 (-IN), X2.8 (VCC)
VCC_12V: R4.1, R5.2, U3.4 (-IN), U3.6 (-IN), U3.8 (-IN), U3.10 (-IN), U4.6 (-IN)
VCC_24V: J1.1, J2.1, R4.2, U2.IN+ (VIN), U3.3 (V+), U4.8 (V+)

Notes on the sheet:
Power Supply for ESP8266 (3.3V)
ESP8266-based WiFi Interface for Venta Humidifier, Version 0.01
Venta Connected ESP
Actuators: Emulate power On/Off button, emulate UP button, override error LED
Sensors: Detect if LEDs (Power, level, error) are on, check if case open sensor (button) is triggered
Microcontroller: ESP8266, Board: ESP-12F
Main PCB as blackbox (only connector):
All pins of the connectors potentially carry 24V => cannot directly feed into Arduino!
A linear voltage regulator like the L78M05 gets too hot, so a step-down converter is required.
Voltage (Off and On)
23.2 20.8 GND 20.8 5.1 20.8 5.1 20.8 5.1 21.7
23.0 1.3 GND 1.3 GND 1.3 GND 1.3 GND 5.1
Turning the device on has no effect on the voltages of the LED and the BTN pins. A button press connects to GND, a burning LED causes the voltage to drop from 20.8V to 1.3V, except for the error LED, which drops from 21.7V to 5.1V when turned on.
As the LEDs and the button pins are not disabled when the device appears off, one can still flash the leds programmatically!
All Input pins (PIN_1, PIN_2, PIN_3, PIN_ON, PIN_ERR and PIN_OPEN) must enable internal pull-up resistors!

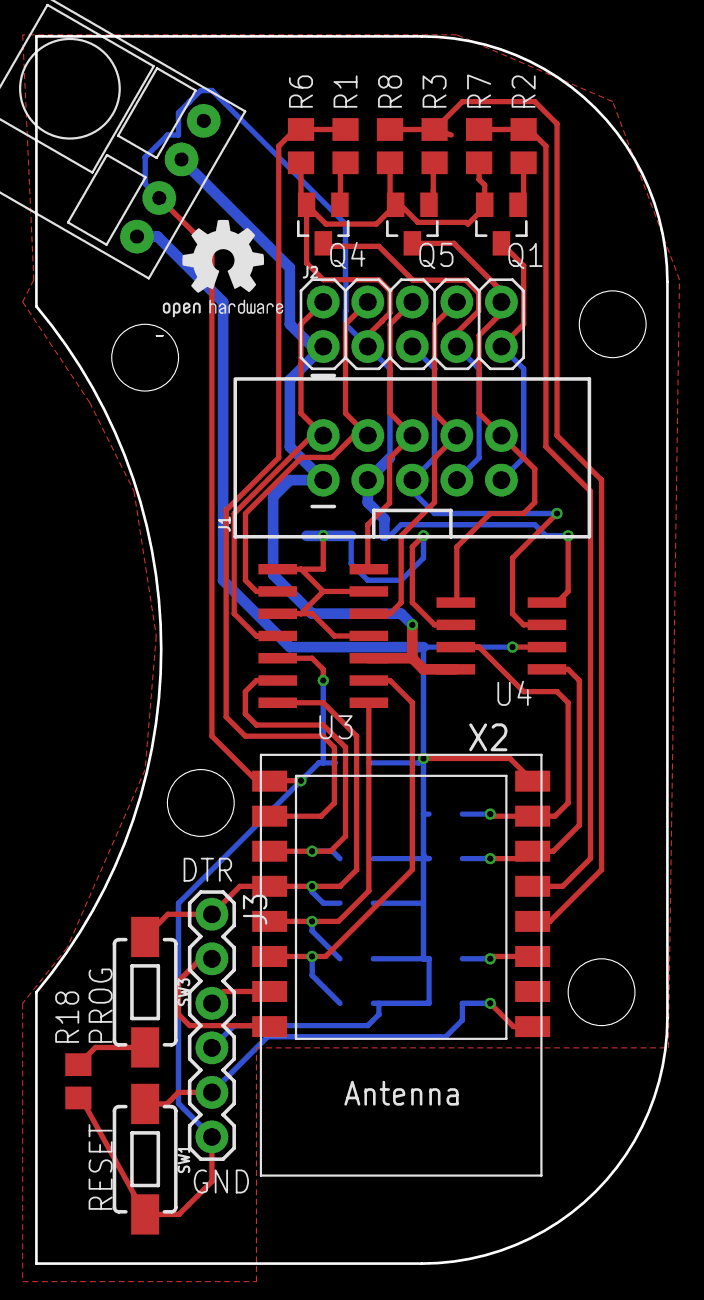
[picture p60: board VentaConnected_ESP8266_V1.0_2018-10-06.brd from above]

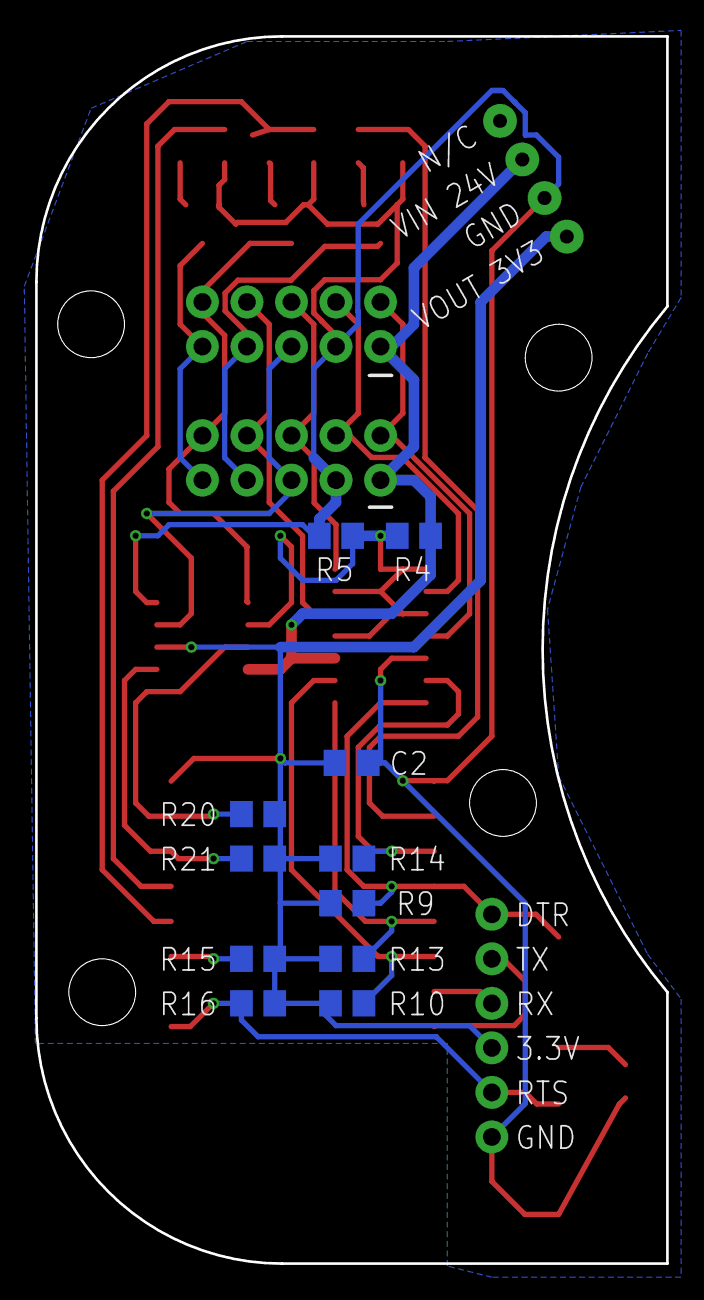
[picture p61: board VentaConnected_ESP8266_V1.0_2018-10-06.brd from below]

Board: 2 copper layers, 36.0 x 70.0 mm, 31 parts (11 on the bottom side), 29 nets.
