open-tools/VentaConnected/VentaConnected_Arduino_V0.01_2017-12-03.brd

## EAGLE design VentaConnected_Arduino_V0.01_2017-12-03.brd (2017-12-09)

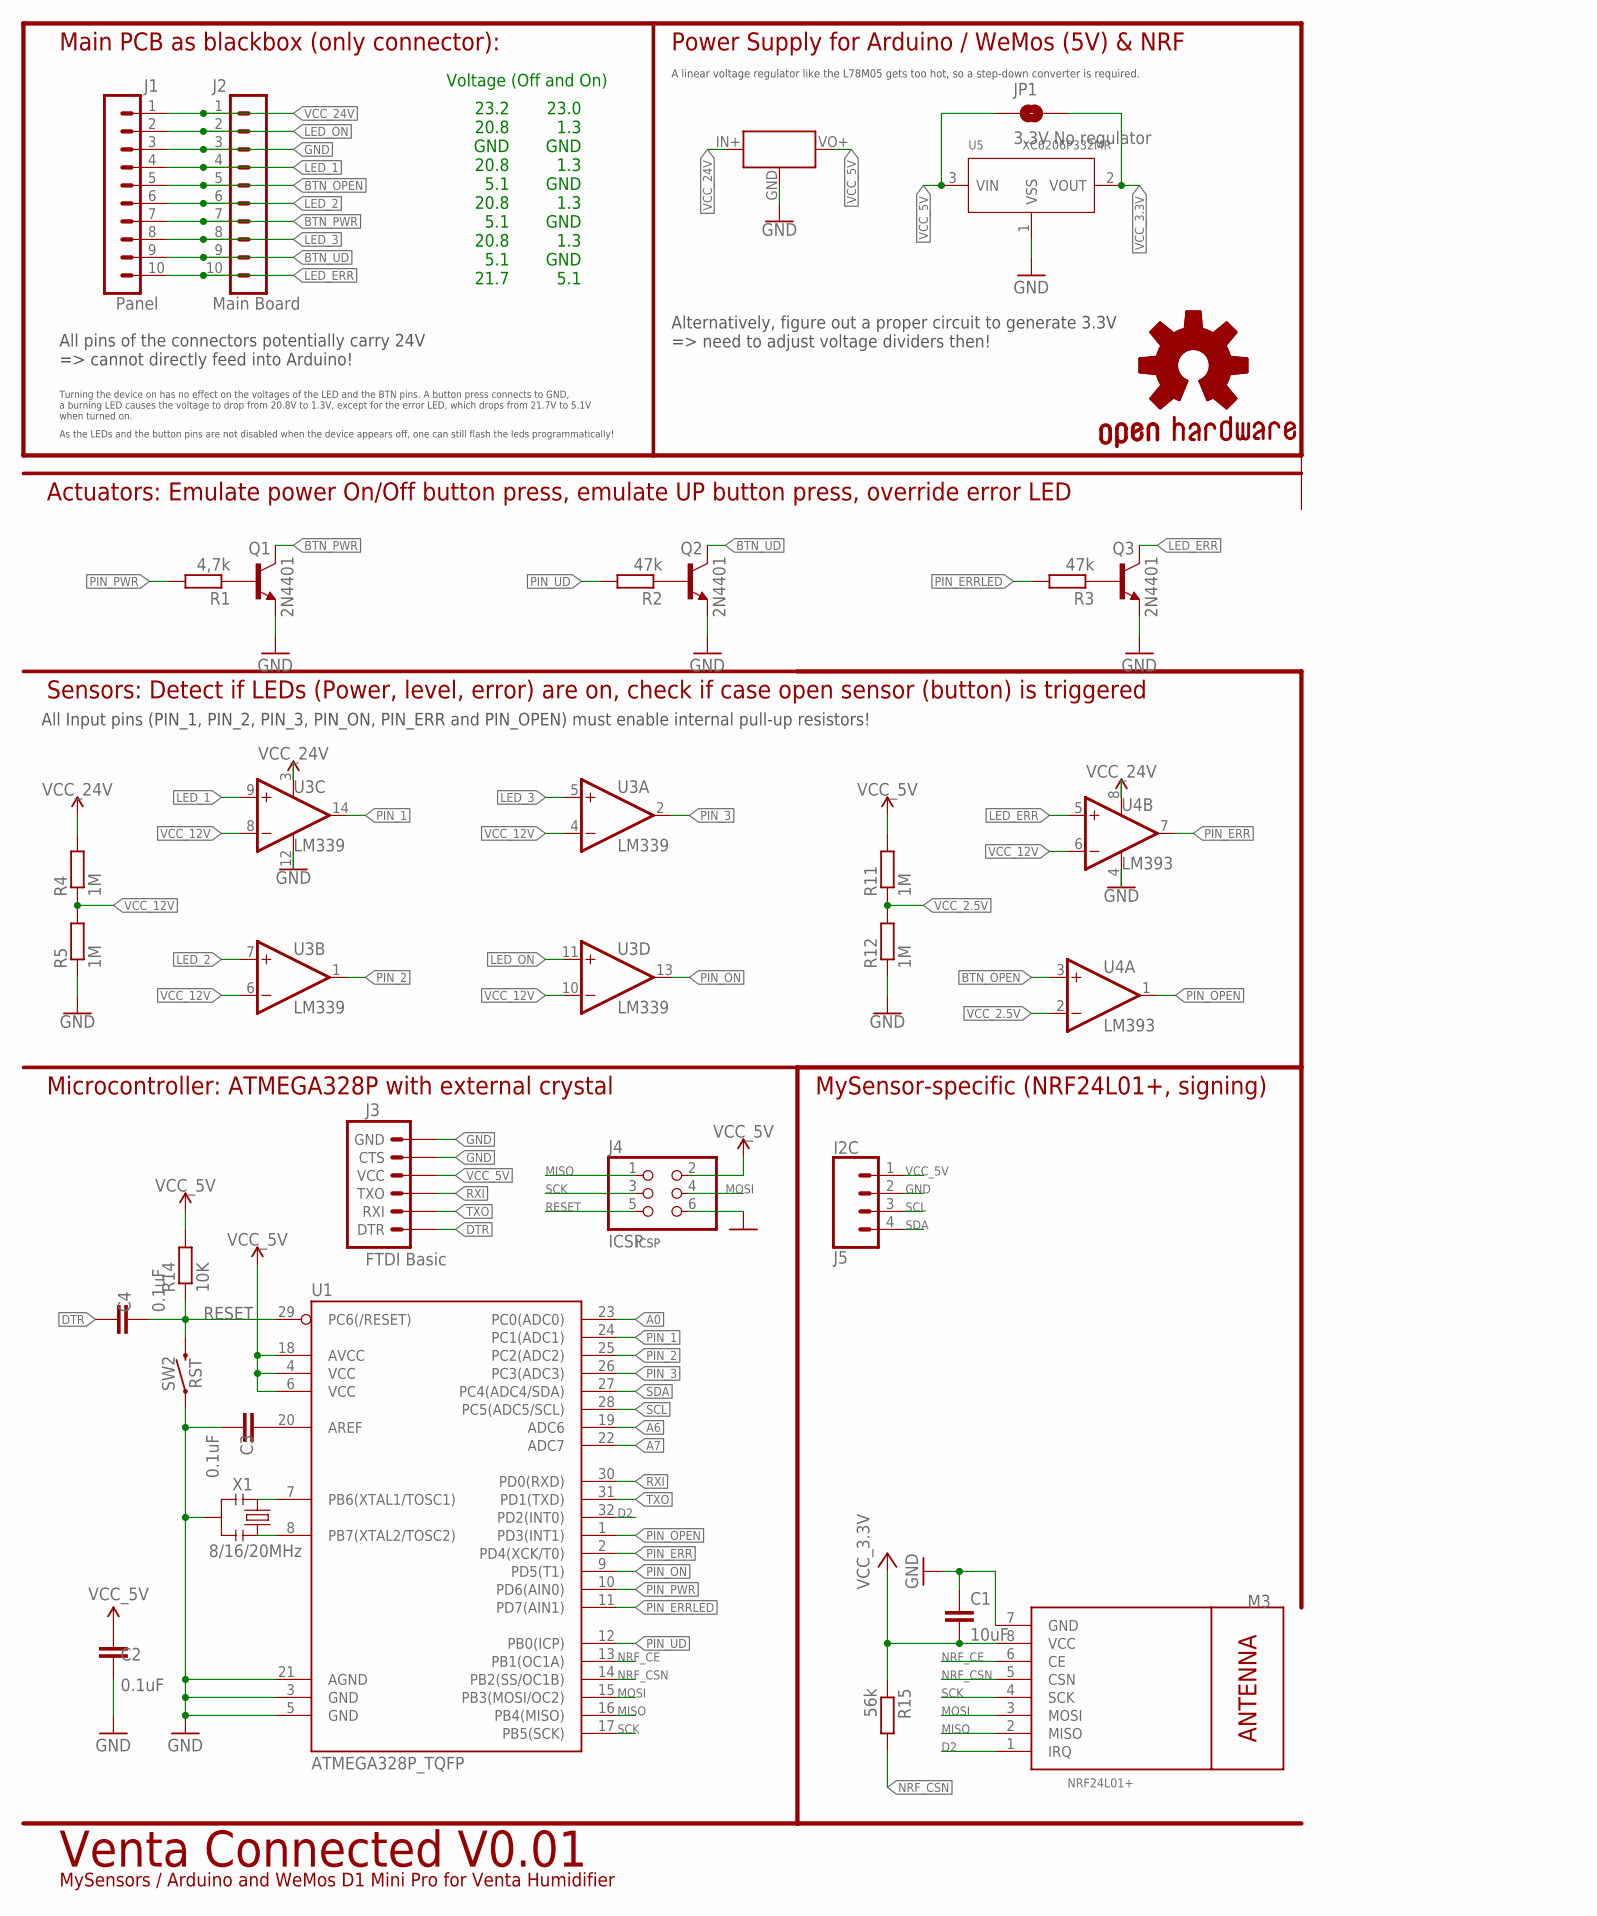
[picture p62: schematic VentaConnected_Arduino_V0.01_2017-12-03.sch]

Parts:
C1: 10uF; C0805
C2, C3, C4: 0.1uF; C0805
GOLD_ORB_SM1: OSHWLOGO_GOLD_ORB_SM; OSHW2
J1: Panel; 2X5-SHROUDED
J2: Main Board; 2X5
J3: FTDI Basic; 1X06
J4: ICSP; 2X03
J5: I2C; 1X04
JP1: 3.3V No regulator; SMT-JUMPER_2_NO_SILK
M3: NRF24L01+; WIRELESS-NRF24L01-SMD
Q1, Q2, Q3: 2N4401; SOT23-BEC
R1: 4,7k; R0805
R2, R3: 47k; R0805
R4, R5, R11, R12: 1M; R0805
R14: 10K; R0805
R15: 56k; R0805
SW2: RST; TACTILE_SWITCH_SMD_6.0X3.5MM
U1: ATMEGA328P_TQFP; TQFP32-08
U2: MINI_BUCK_CONVERTER_UPSIDEDOWN; MINI_BUCK_CONVERTER_UPDOWN
U3: LM339; SO14
U4: LM393; SO08
U5: XC6206P332MR; SOT-23
X1: 8/16/20MHz; RESONATOR-SMD-1:1

Connections:
A0: U1.23 (PC0(ADC0))
A6: U1.19 (ADC6)
A7: U1.22 (ADC7)
AREF: C3.2, U1.20 (AREF)
BTN_OPEN: J1.5, J2.5, U4.3 (+IN)
BTN_PWR: J1.7, J2.7, Q1.C
BTN_UD: J1.9, J2.9, Q2.C
D2: M3.1 (IRQ), U1.32 (PD2(INT0))
DTR: C4.2, J3.1 (DTR)
GND: C1.1, C2.1, C3.1, J1.3, J2.3, J3.5 (CTS), J3.6 (GND), J4.6, J5.2, M3.7 (GND), Q1.E, Q2.E, Q3.E, R5.1, R12.1, SW2.1, U1.3 (GND), U1.5 (GND), U1.21 (AGND), U2.GND, U3.12 (V-), U4.4 (V-), U5.1 (VSS), X1.2
LED_1: J1.4, J2.4, U3.9 (+IN)
LED_2: J1.6, J2.6, U3.7 (+IN)
LED_3: J1.8, J2.8, U3.5 (+IN)
LED_ERR: J1.10, J2.10, Q3.C, U4.5 (+IN)
LED_ON: J1.2, J2.2, U3.11 (+IN)
MISO: J4.1, M3.2 (MISO), U1.16 (PB4(MISO))
MOSI: J4.4, M3.3 (MOSI), U1.15 (PB3(MOSI/OC2))
unnamed: Q1.B, R1.1
unnamed: Q3.B, R3.1
unnamed: Q2.B, R2.1
unnamed: U1.8 (PB7(XTAL2/TOSC2)), X1.3
unnamed: U1.7 (PB6(XTAL1/TOSC1)), X1.1
NRF_CE: M3.6 (CE), U1.13 (PB1(OC1A))
NRF_CSN: M3.5 (CSN), R15.2, U1.14 (PB2(SS/OC1B))
PIN_1: U1.24 (PC1(ADC1)), U3.14 (OUT)
PIN_2: U1.25 (PC2(ADC2)), U3.1 (OUT)
PIN_3: U1.26 (PC3(ADC3)), U3.2 (OUT)
PIN_ERR: U1.2 (PD4(XCK/T0)), U4.7 (OUT)
PIN_ERRLED: R3.2, U1.11 (PD7(AIN1))
PIN_ON: U1.9 (PD5(T1)), U3.13 (OUT)
PIN_OPEN: U1.1 (PD3(INT1)), U4.1 (OUT)
PIN_PWR: R1.2, U1.10 (PD6(AIN0))
PIN_UD: R2.2, U1.12 (PB0(ICP))
RESET: C4.1, J4.5, R14.1, SW2.2, U1.29 (PC6(/RESET))
RXI: J3.3 (TXO), U1.30 (PD0(RXD))
SCK: J4.3, M3.4 (SCK), U1.17 (PB5(SCK))
SCL: J5.3, U1.28 (PC5(ADC5/SCL))
SDA: J5.4, U1.27 (PC4(ADC4/SDA))
TXO: J3.2 (RXI), U1.31 (PD1(TXD))
VCC_2.5V: R11.1, R12.2, U4.2 (-IN)
VCC_3.3V: C1.2, JP1.2, M3.8 (VCC), R15.1, U5.2 (VOUT)
VCC_5V: C2.2, J3.4 (VCC), J4.2, J5.1, JP1.1, R11.2, R14.2, U1.4 (VCC), U1.6 (VCC), U1.18 (AVCC), U2.VO+ (VOUT), U5.3 (VIN)
VCC_12V: R4.1, R5.2, U3.4 (-IN), U3.6 (-IN), U3.8 (-IN), U3.10 (-IN), U4.6 (-IN)
VCC_24V: J1.1, J2.1, R4.2, U2.IN+ (VIN), U3.3 (V+), U4.8 (V+)

Notes on the sheet:
MySensor-specific (NRF24L01+, signing)
Power Supply for Arduino / WeMos (5V) & NRF
MySensors / Arduino and WeMos D1 Mini Pro for Venta Humidifier
Venta Connected V0.01
Actuators: Emulate power On/Off button press, emulate UP button press, override error LED
Sensors: Detect if LEDs (Power, level, error) are on, check if case open sensor (button) is triggered
Microcontroller: ATMEGA328P with external crystal
Alternatively, figure out a proper circuit to generate 3.3V => need to adjust voltage dividers then!
Main PCB as blackbox (only connector):
All pins of the connectors potentially carry 24V => cannot directly feed into Arduino!
A linear voltage regulator like the L78M05 gets too hot, so a step-down converter is required.
Voltage (Off and On)
23.2 20.8 GND 20.8 5.1 20.8 5.1 20.8 5.1 21.7
23.0 1.3 GND 1.3 GND 1.3 GND 1.3 GND 5.1
Turning the device on has no effect on the voltages of the LED and the BTN pins. A button press connects to GND, a burning LED causes the voltage to drop from 20.8V to 1.3V, except for the error LED, which drops from 21.7V to 5.1V when turned on.
As the LEDs and the button pins are not disabled when the device appears off, one can still flash the leds programmatically!
ICSP
All Input pins (PIN_1, PIN_2, PIN_3, PIN_ON, PIN_ERR and PIN_OPEN) must enable internal pull-up resistors!

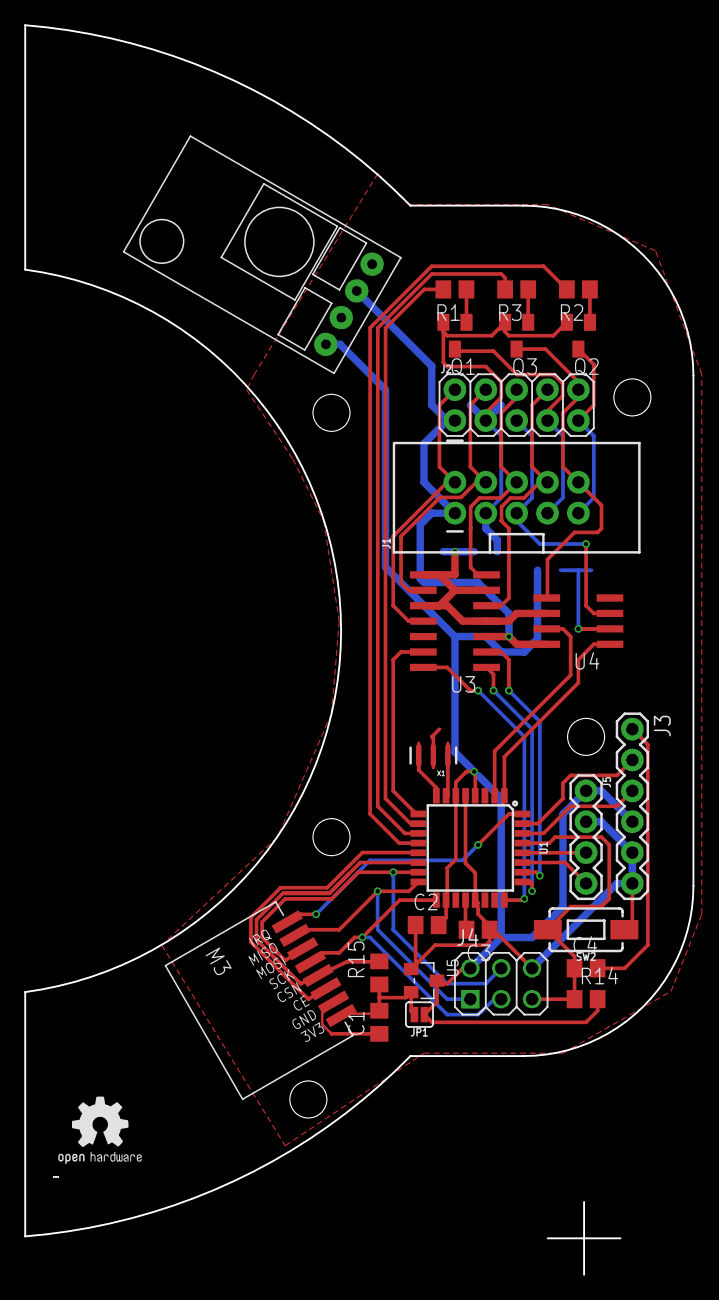
[picture p63: board VentaConnected_Arduino_V0.01_2017-12-03.brd from above]

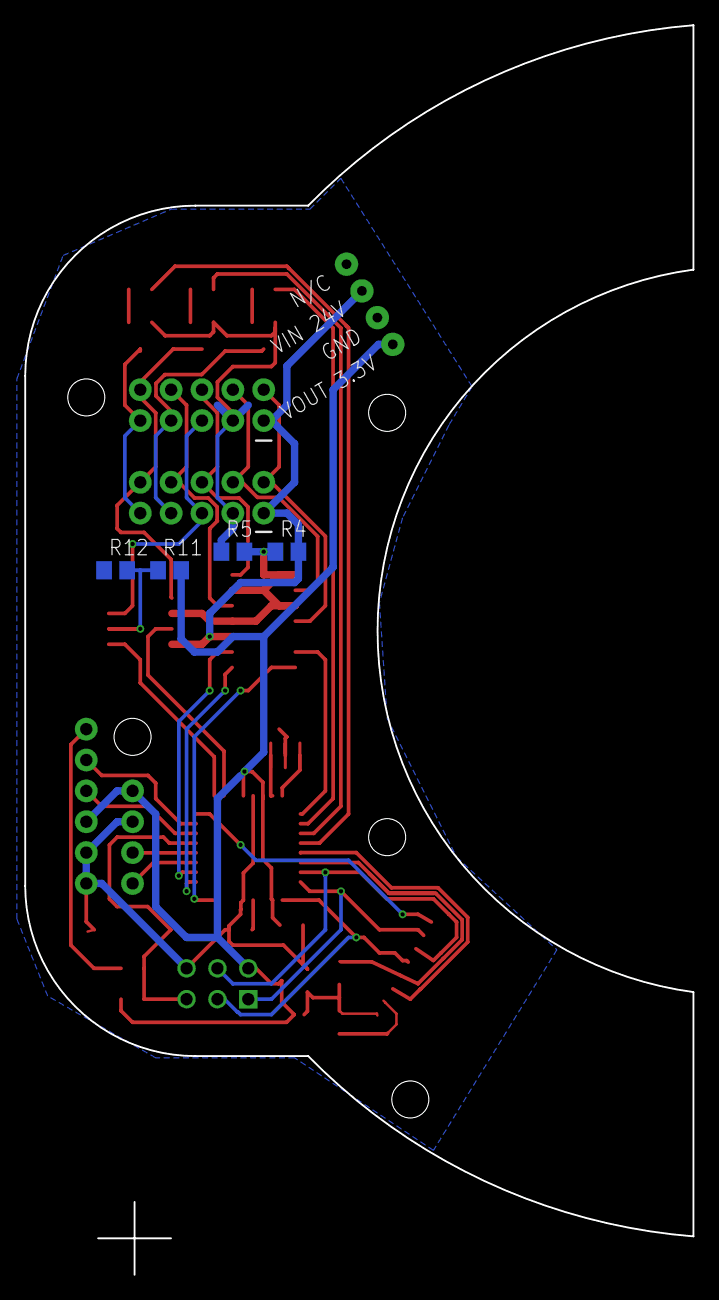
[picture p64: board VentaConnected_Arduino_V0.01_2017-12-03.brd from below]

Board: 2 copper layers, 55.0 x 102.8 mm, 31 parts (4 on the bottom side), 41 nets.
