open-tools/VentaConnected/(commit log)

2017-10-30 Initial commit, breadboard circuit is working (with MySensors), PCB design missing
    [MySensors_Interfacing24V.brd, MySensors_Interfacing24V.sch, VentaConnected_Arduino.brd, VentaConnected_Arduino.sch, VentaConnected_Arduino_V0.01_2017-10-11.brd, VentaConnected_Arduino_V0.01_2017-10-11.sch, VentaConnected_Arduino_V0.01_2017-10-21.brd, VentaConnected_Arduino_V0.01_2017-10-21.sch]
2017-12-09 First PCB versions finished, breadboard prototype with arduino fully running
    [MySensors_Interfacing24V.brd, MySensors_Interfacing24V.sch, VentaConnected_Arduino.brd, VentaConnected_Arduino.sch, VentaConnected_Arduino_V0.01_2017-10-11.brd, VentaConnected_Arduino_V0.01_2017-10-11.sch, VentaConnected_Arduino_V0.01_2017-10-21.brd, VentaConnected_Arduino_V0.01_2017-10-21.sch]
2018-10-14 V1.0: ESP-Version finished
    [VentaConnected_Arduino.brd, VentaConnected_Arduino.sch, VentaConnected_Arduino_V0.01_2017-10-11.brd, VentaConnected_Arduino_V0.01_2017-10-11.sch, VentaConnected_Arduino_V0.01_2017-10-21.brd, VentaConnected_Arduino_V0.01_2017-10-21.sch, VentaConnected_Arduino_V0.01_2017-10-27.brd, VentaConnected_Arduino_V0.01_2017-10-27.sch]
2018-10-14 Add BOM
    [VentaConnected_ESP8266_V1.0_2018-10-06.csv]
