open-tools/VentaConnected/(notices)

Notices in the files:
parts and their libraries:
SparkFun-Jumpers: Licensing: Creative Commons ShareAlike 4.0 International - https://creativecommons.org/licenses/by-sa/4.0
NXP_60_26022015: This library may be distributed and adapted freely for any purpose, as long as NXP is credited and any new creation is licensed under the same terms.
